binaryBeachLLC/tradewind/hardware/fab/drc_report.txt

** Drc report for tradewind.kicad_pcb **
** Created on 2026-10-11T23:57:10-1000 **

** Found 0 DRC violations **

** Found 0 unconnected pads **

** Found 0 Footprint errors **

** End of Report **
