binaryBeachLLC/tradewind/docs/figures/mech_mass_table.png

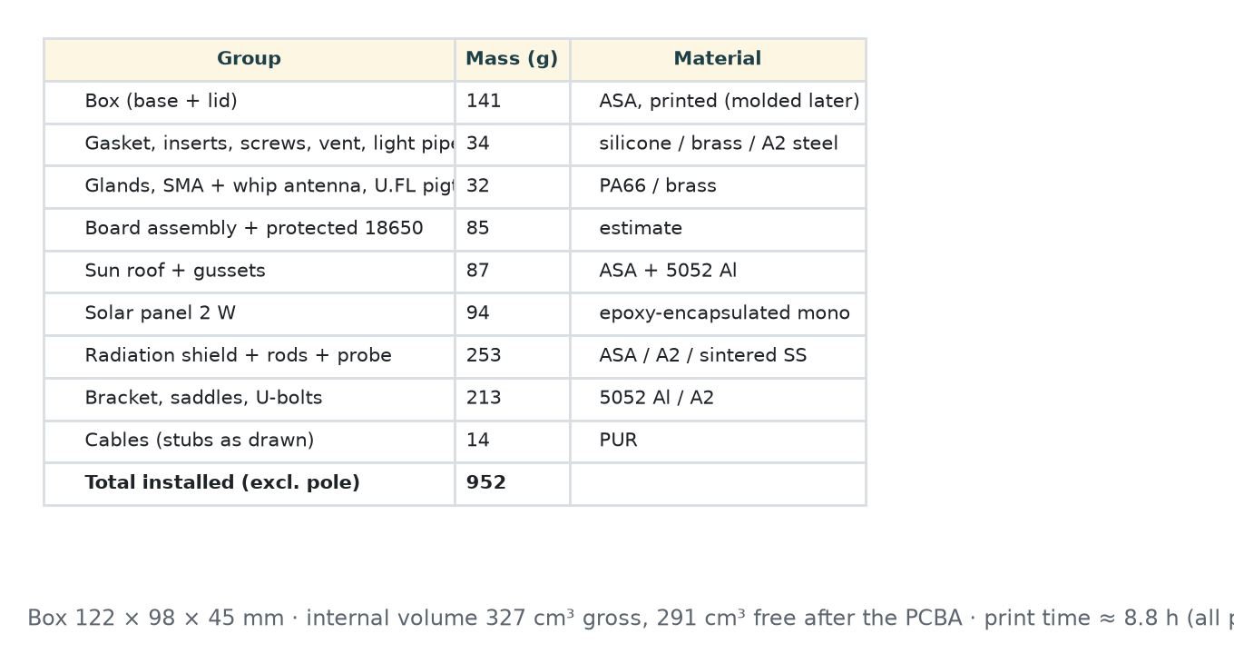
docs/figures/mech_mass_table.png
