binaryBeachLLC/tradewind/mechanical/out/previews/enclosure_front34.png

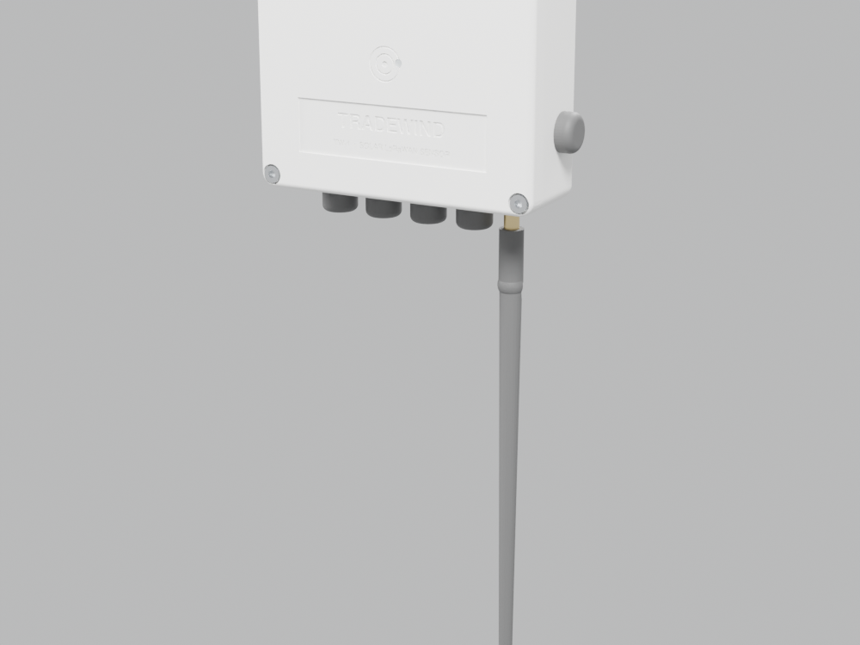
mechanical/out/previews/enclosure_front34.png
