binaryBeachLLC/tradewind/mechanical/out/previews/exploded_front34.png

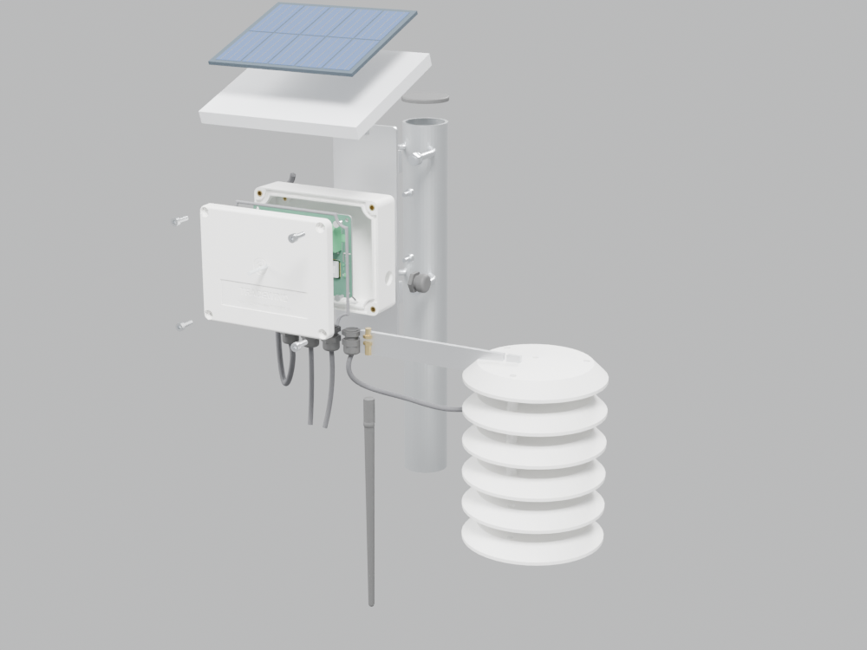
mechanical/out/previews/exploded_front34.png
