binaryBeachLLC/tradewind/render/out/jpg/kicad_pcb_bottom.jpg

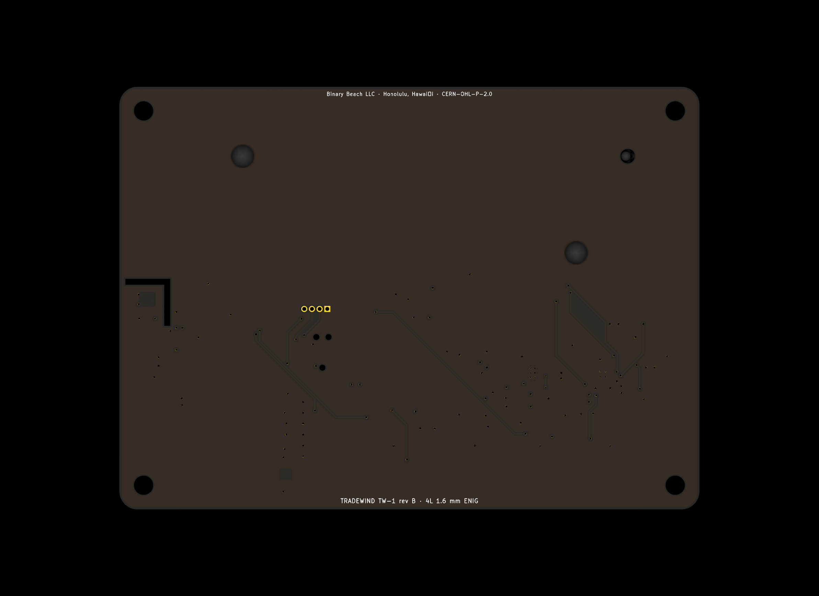
render/out/jpg/kicad_pcb_bottom.jpg
