binaryBeachLLC/tradewind/render/out/jpg/kicad_pcb_iso.jpg

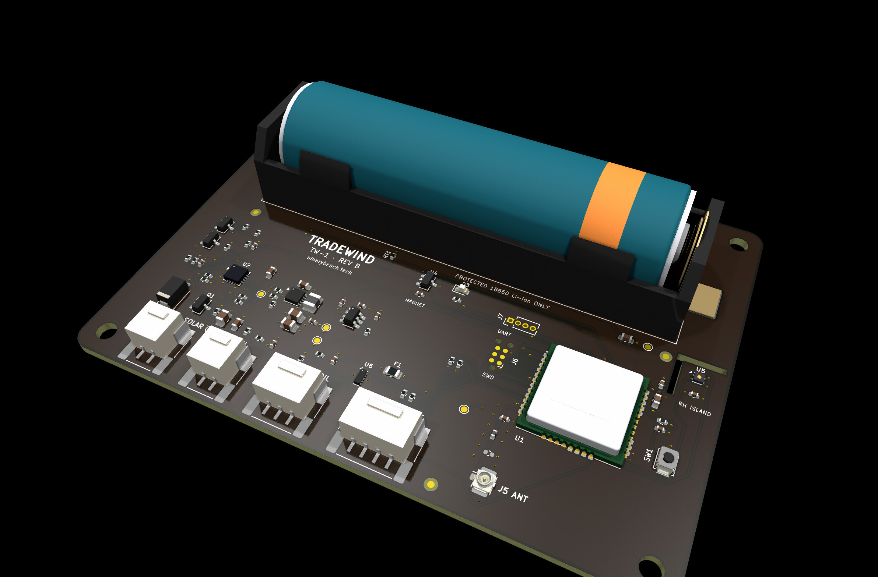
render/out/jpg/kicad_pcb_iso.jpg
