binaryBeachLLC/tradewind/render/out/jpg/pcb_top_ortho.jpg

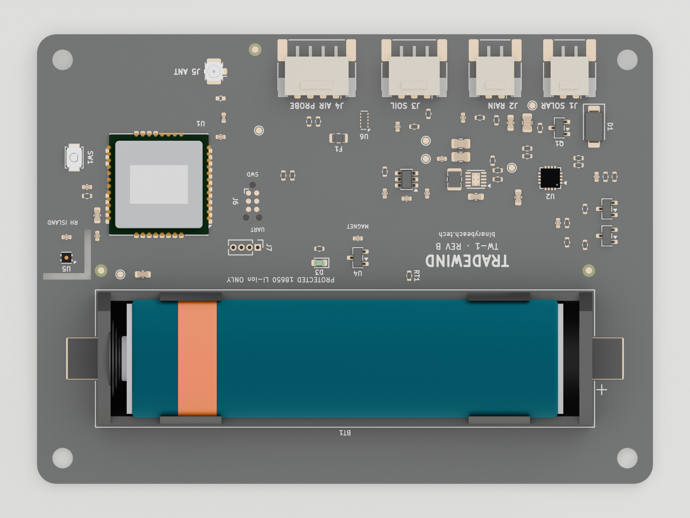
render/out/jpg/pcb_top_ortho.jpg
