binaryBeachLLC/tradewind/hardware/fab/BOM_JLCPCB.csv

Comment | Designator | Footprint | LCSC Part #
SOLAR S2B-PH-SM4-TB(LF)(SN) | J1 | JST_PH_S2B-PH-SM4-TB_1x02-1MP_P2.00mm_Horizontal
SMAJ12CA SMAJ12CA | D1 | D_SMA | C113951
DMP3099L DMP3099L-7 | Q1 | SOT-23 | C155407
100k RC0402FR-07100KL | R1,R11,R12,R15,R16 | R_0402_1005Metric
10µF GRM21BR61E106KA73L | C1 | C_0805_2012Metric
1µF GRM188R61E105KA12D | C2 | C_0603_1608Metric
BQ24074RGT BQ24074RGTR | U2 | VQFN-16-1EP_3x3mm_P0.5mm_EP1.6x1.6mm | C54313
1.78k RC0402FR-071K78L | R4 | R_0402_1005Metric
1.62k RC0402FR-071K62L | R5 | R_0402_1005Metric
4.7µF GRM188R61A475KE15D | C4,C5 | C_0603_1608Metric
18650 1042 | BT1 | BatteryHolder_Keystone_1042_1x18650
10k B3380 NCP15XH103F03RC | RT1 | R_0402_1005Metric
TPS63900 TPS63900DSKR | U3 | WSON-10-1EP_2.5x2.5mm_P0.5mm_EP1.2x2mm_ThermalVias | C2683460
10µF GRM188R61A106KE69D | C6,C12 | C_0603_1608Metric
2.2µH DFE252012F-2R2M=P2 | L1 | L_1008_2520Metric
36.5k RC0402FR-0736K5L | R6 | R_0402_1005Metric
0 RC0402JR-070RL | R7 | R_0402_1005Metric
16.2k RC0402FR-0716K2L | R8 | R_0402_1005Metric
22µF GRM21BR61A226ME51L | C7,C8 | C_0805_2012Metric
100nF GRM155R71C104KA88D | C3,C9,C11,C13,C16,C17,C21 | C_0402_1005Metric
AO3401A AO3401A | Q2 | SOT-23 | C15127
1M RC0402FR-071ML | R2,R9,R10,R21,R23 | R_0402_1005Metric
BSS138 BSS138LT1G | Q3 | SOT-23 | C78284
10nF GRM155R71C103KA01D | C10 | C_0402_1005Metric
330k RC0402FR-07330KL | R3 | R_0402_1005Metric
RAK3172-8-SM-I RAK3172-8-SM-I | U1 | RAK3172 | C2924540
10k RC0402FR-0710KL | R13,R24 | R_0402_1005Metric
RESET B3U-1000P | SW1 | SW_SPST_B3U-1000P
U.FL U.FL-R-SMT-1(10) | J5 | U.FL_Hirose_U.FL-R-SMT-1_Vertical | C88374
7.5nH LQG15HS7N5J02D | L2 | L_0402_1005Metric
1.8pF GJM1555C1H1R8BB01D | C14 | C_0402_1005Metric
GREEN LTST-C191KGKT | D3 | LED_0603_1608Metric
2.2k RC0402FR-072K2L | R14 | R_0402_1005Metric
DRV5032FB DRV5032FBDBZR | U4 | SOT-23 | C1850416
SHT40-BD1B SHT40-BD1B-R2 | U5 | Sensirion_DFN-4_1.5x1.5mm_P0.8mm_SHT4x_NoCentralPad | C2758077
4.7k RC0402FR-074K7L | R17,R18 | R_0402_1005Metric
AIR PROBE S4B-PH-SM4-TB(LF)(SN) | J4 | JST_PH_S4B-PH-SM4-TB_1x04-1MP_P2.00mm_Horizontal
100mA MF-PSMF010X-2 | F1 | Fuse_0805_2012Metric
100 RC0402FR-07100RL | R19,R20,R25 | R_0402_1005Metric
TPD4E02B04 TPD4E02B04DQAR | U6 | USON-10_2.5x1.0mm_P0.5mm | C1974361
TPS22917 TPS22917DBVR | U7 | SOT-23-6 | C2155396
1µF GRM155R61A105KE15D | C19,C20 | C_0402_1005Metric
1nF GRM155R71H102KA01D | C18 | C_0402_1005Metric
SOIL S3B-PH-SM4-TB(LF)(SN) | J3 | JST_PH_S3B-PH-SM4-TB_1x03-1MP_P2.00mm_Horizontal
1k RC0402FR-071KL | R22 | R_0402_1005Metric
RAIN S2B-PH-SM4-TB(LF)(SN) | J2 | JST_PH_S2B-PH-SM4-TB_1x02-1MP_P2.00mm_Horizontal
22nF GRM155R71C223KA01D | C22 | C_0402_1005Metric
