binaryBeachLLC/tradewind/mechanical/out/tradewind_assembly.step

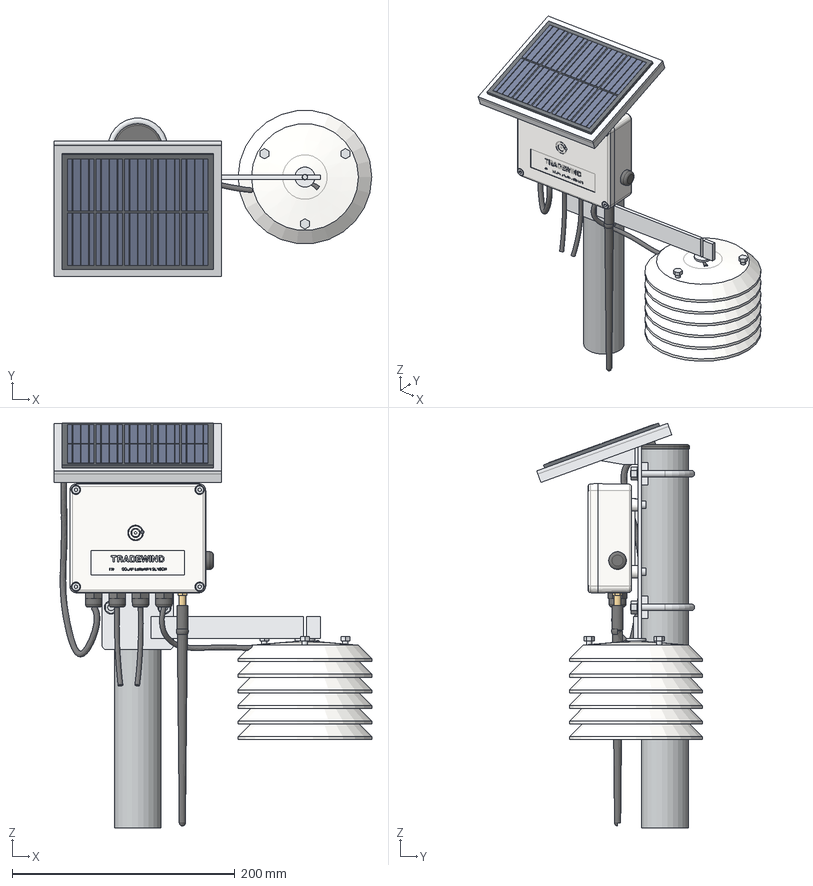
[picture p100: CAD file, 2026-10-12]
mechanical/out/tradewind_assembly.step
285.0 x 148.6 x 363.4 mm
base
lid
light_pipe
roof
panel
panel_cells
panel_busbars
panel_jbox
roof_gusset_L
roof_gusset_R
shield_cap
shield_plate_1
shield_plate_2
shield_plate_3
shield_plate_4
shield_plate_5
shield_rods
shield_spacers
probe_holder
probe_tip
probe_body
shield_arm
bracket_plate
ubolts
pole_saddles
pole_cap
pole
gasket
inserts
lid_screws
pcb_screws
bracket_screws
glands_pg7
sma_bulkhead
antenna_915
ufl_pigtail
vent_m12
cable_solar
cable_probe
cable_rain
cable_soil
pcba
