binaryBeachLLC/tradewind/hardware/fab/3d/tradewind_revB.step

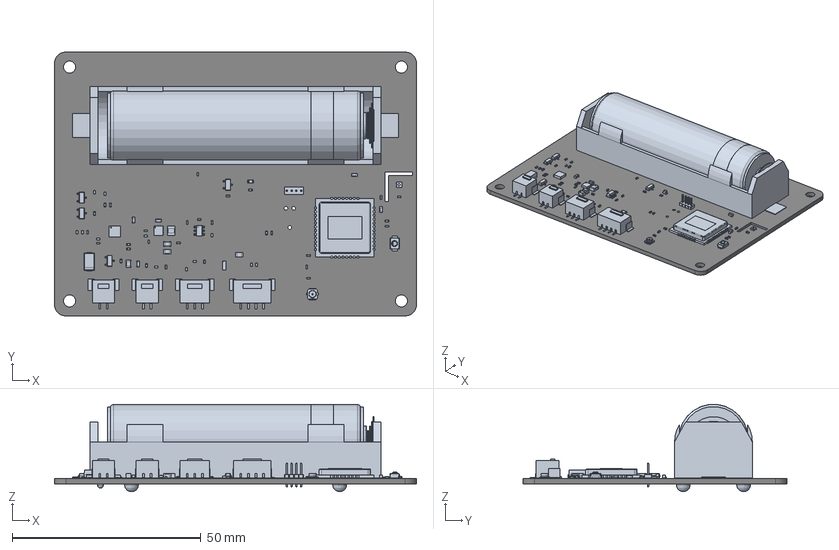
[picture p101: CAD file, 2026-10-12]
hardware/fab/3d/tradewind_revB.step
96.0 x 70.0 x 23.1 mm
R_0402_1005Metric x 26
housing x 4
metal x 4
C_0402_1005Metric x 14
Fuse_0805_2012Metric
pcb
pads x 3
shield
label
C_0603_1608Metric x 5
C_0805_2012Metric x 3
SOT-23 x 4
LED_0603_1608Metric
U.FL_Hirose_U.FL-R-SMT-1_Vertical
tradewind_revB 1.38.1
PinHeader_1x04_P1.27mm_Vertical
window
D_SMA
SOT-23-6
L_1008_2520Metric
USON-10_2.5x1.0mm_P0.5mm
SW_SPST_B3U-1000P
L_0402_1005Metric
pin1
BatteryHolder_Keystone_1042_1x18650
wrap
band
pos
neg
tradewind_PCB
