binaryBeachLLC/tradewind/hardware/tradewind/3d/JST_PH_S3B-PH-SM4-TB.step

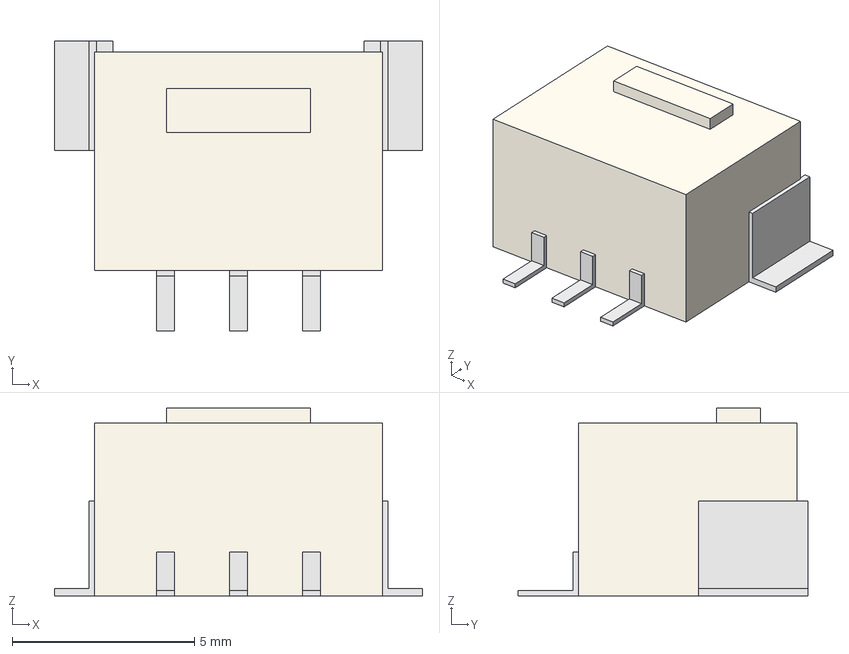
[picture p102: CAD file, 2026-10-12]
hardware/tradewind/3d/JST_PH_S3B-PH-SM4-TB.step
10.1 x 7.95 x 5.15 mm
housing
metal
