binaryBeachLLC/tradewind/mechanical/out/stl/base.stl

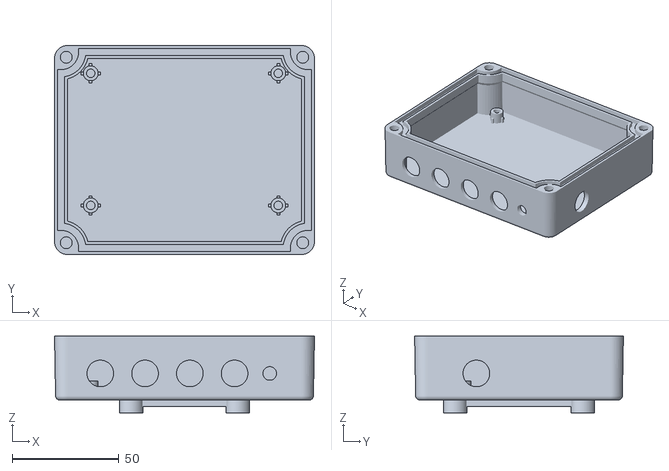
[picture p103: CAD file, 2026-10-12]
mechanical/out/stl/base.stl
122.0 x 98.0 x 36.0
