binaryBeachLLC/tradewind/hardware/tradewind/3d/Cell_18650_protected.step

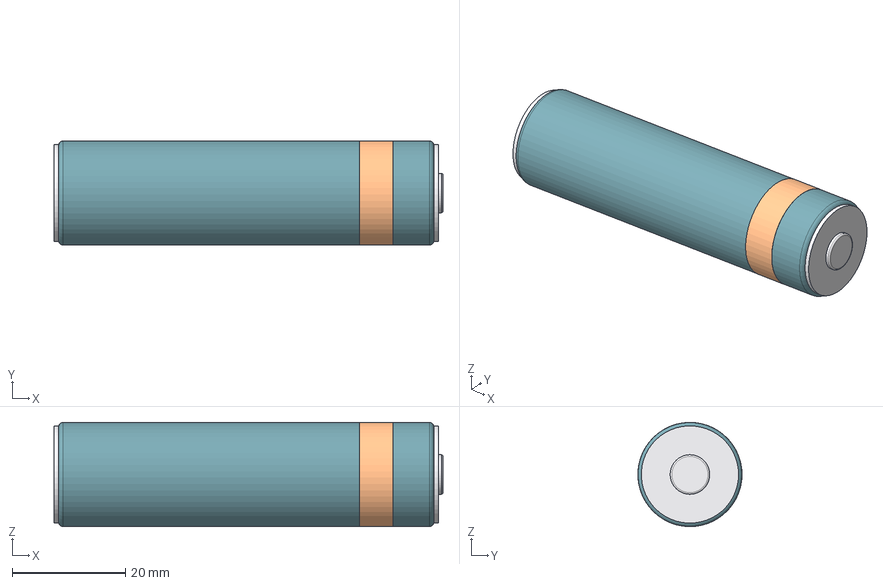
[picture p104: CAD file, 2026-10-12]
hardware/tradewind/3d/Cell_18650_protected.step
68.8 x 18.4 x 18.4 mm
wrap
band
pos
neg
