binaryBeachLLC/tradewind/mechanical/out/stl/roof.stl

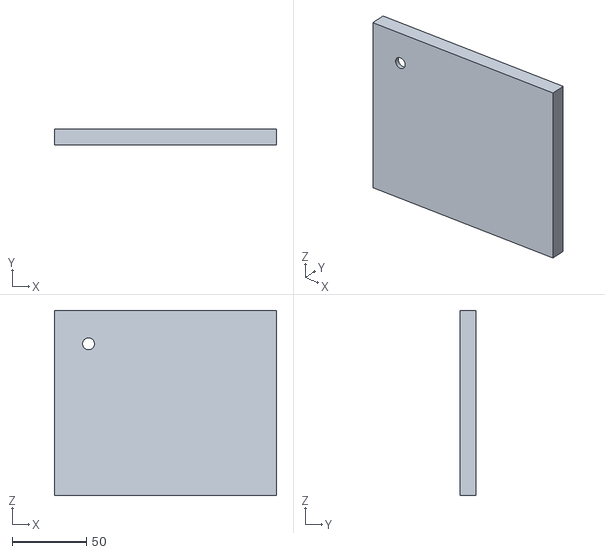
[picture p105: CAD file, 2026-10-12]
mechanical/out/stl/roof.stl
150.0 x 11.0 x 125.0
