binaryBeachLLC/tradewind/hardware/tradewind/3d/JST_PH_S2B-PH-SM4-TB.step

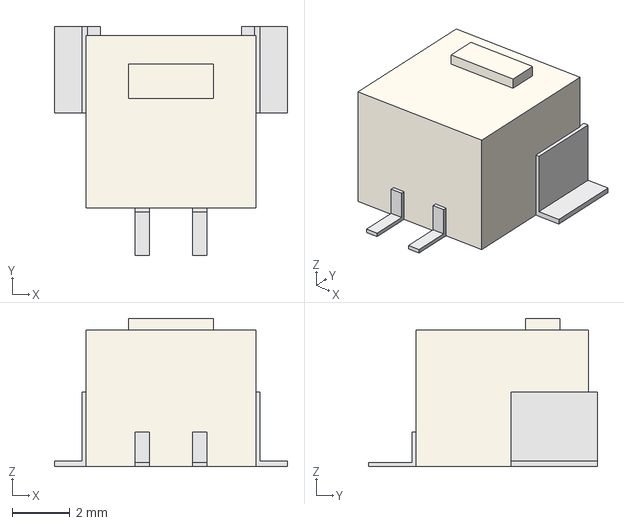
[picture p106: CAD file, 2026-10-12]
hardware/tradewind/3d/JST_PH_S2B-PH-SM4-TB.step
8.10 x 7.95 x 5.15 mm
housing
metal
