binaryBeachLLC/tradewind/mechanical/out/stl/shield_plate_x5.stl

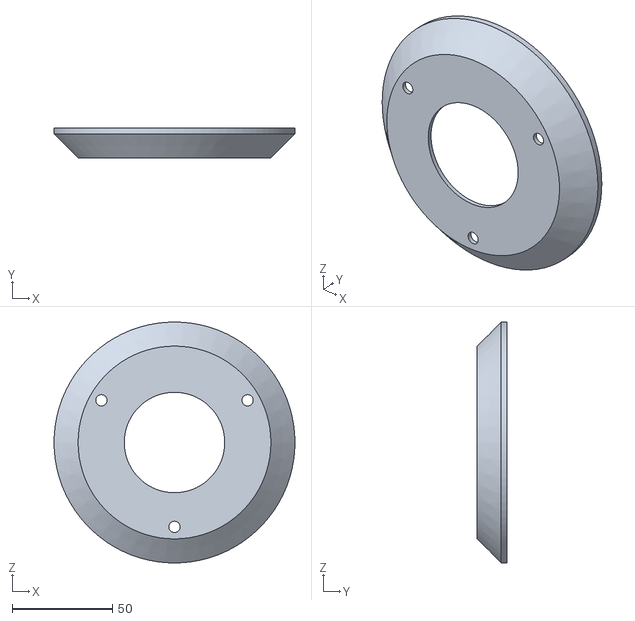
[picture p107: CAD file, 2026-10-12]
mechanical/out/stl/shield_plate_x5.stl
120.0 x 14.8 x 120.0
