binaryBeachLLC/tradewind/hardware/tradewind/3d/RAK3172.step

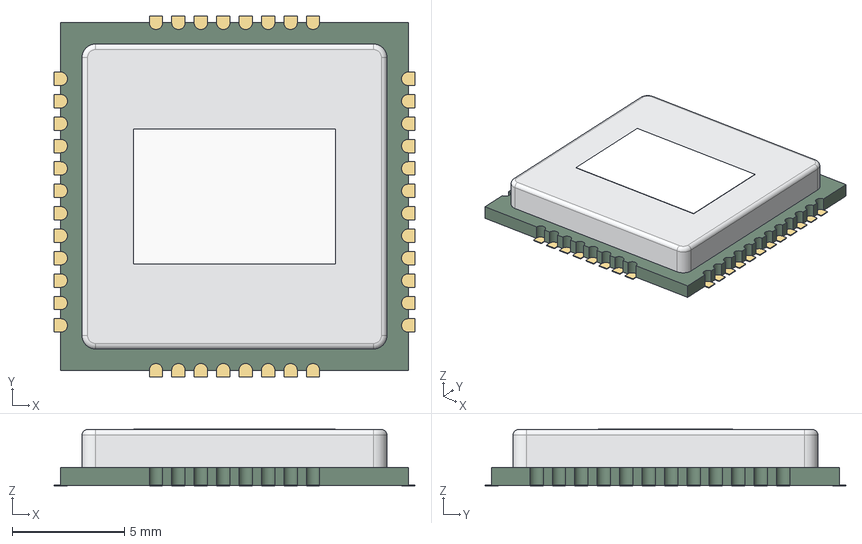
[picture p108: CAD file, 2026-10-12]
hardware/tradewind/3d/RAK3172.step
16.1 x 16.1 x 2.54 mm
pcb
pads
shield
label
