binaryBeachLLC/tradewind/mechanical/out/stl/probe_holder.stl

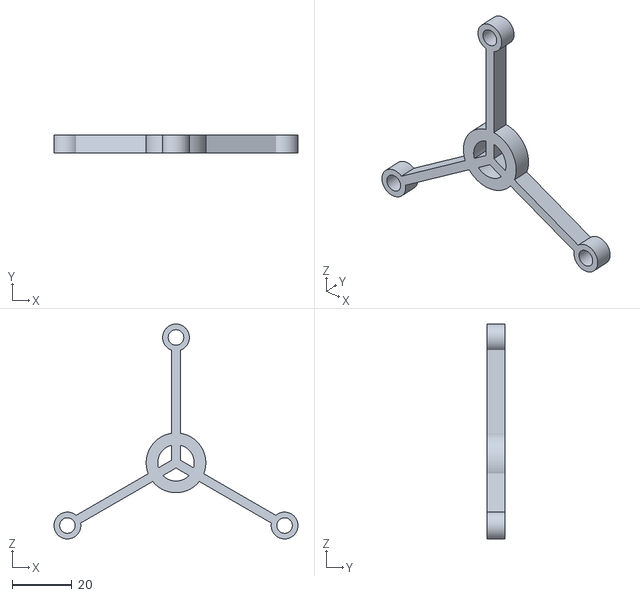
[picture p109: CAD file, 2026-10-12]
mechanical/out/stl/probe_holder.stl
81.7 x 6.00 x 72.0
