binaryBeachLLC/tradewind/mechanical/out/stl/shield_spacers_x15.stl

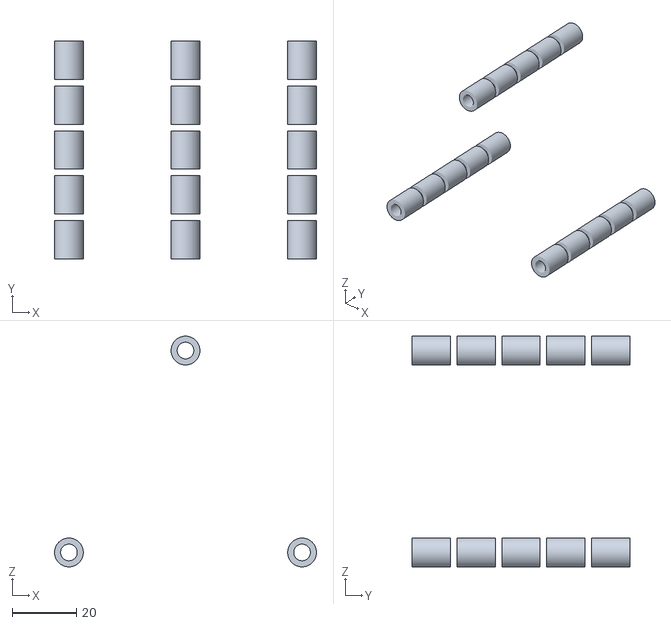
[picture p111: CAD file, 2026-10-12]
mechanical/out/stl/shield_spacers_x15.stl
81.7 x 68.0 x 72.0
