binaryBeachLLC/tradewind/hardware/tradewind/3d/Sensirion_DFN-4_1.5x1.5mm_SHT4x.step

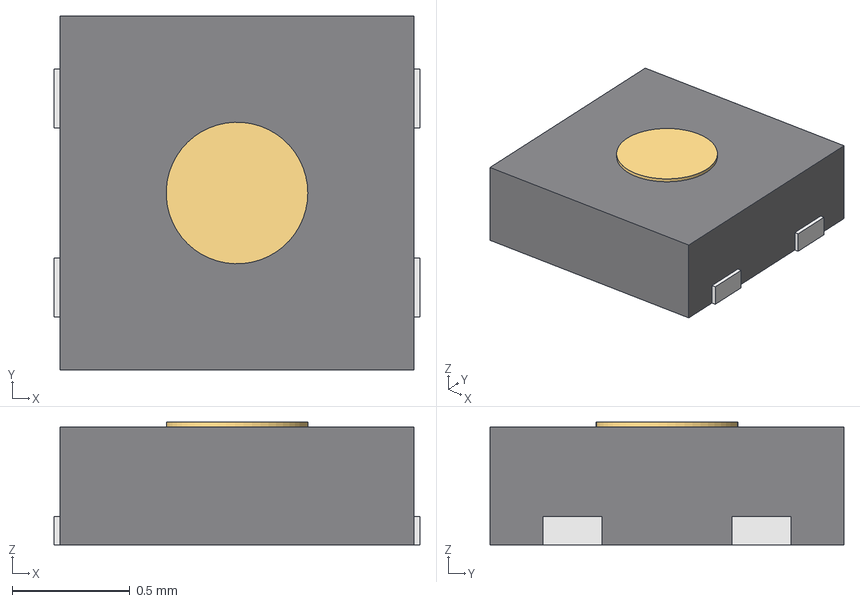
[picture p112: CAD file, 2026-10-12]
hardware/tradewind/3d/Sensirion_DFN-4_1.5x1.5mm_SHT4x.step
1.55 x 1.50 x 0.52 mm
window
pads
