binaryBeachLLC/tradewind/mechanical/out/stl/lid.stl

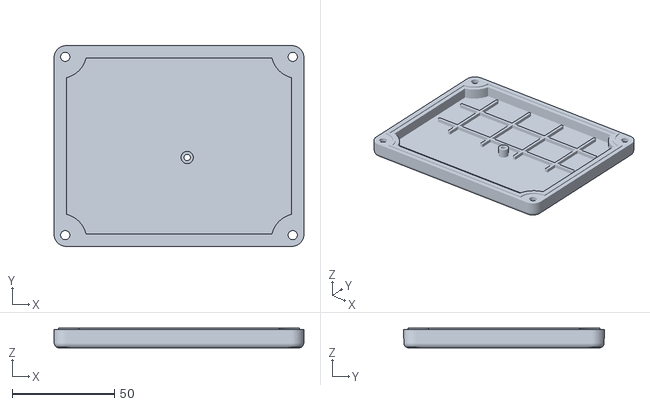
[picture p113: CAD file, 2026-10-12]
mechanical/out/stl/lid.stl
122.0 x 98.0 x 9.75
