binaryBeachLLC/tradewind/hardware/tradewind/3d/VQFN-16_3x3mm_P0.5mm.step

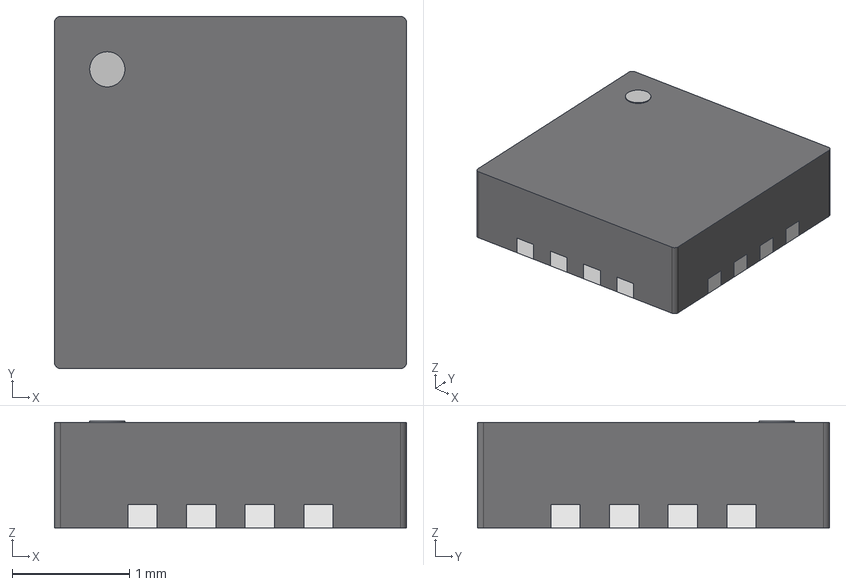
[picture p114: CAD file, 2026-10-12]
hardware/tradewind/3d/VQFN-16_3x3mm_P0.5mm.step
3.00 x 3.00 x 0.91 mm
pads
pin1
