binaryBeachLLC/tradewind/mechanical/out/stl/shield_cap.stl

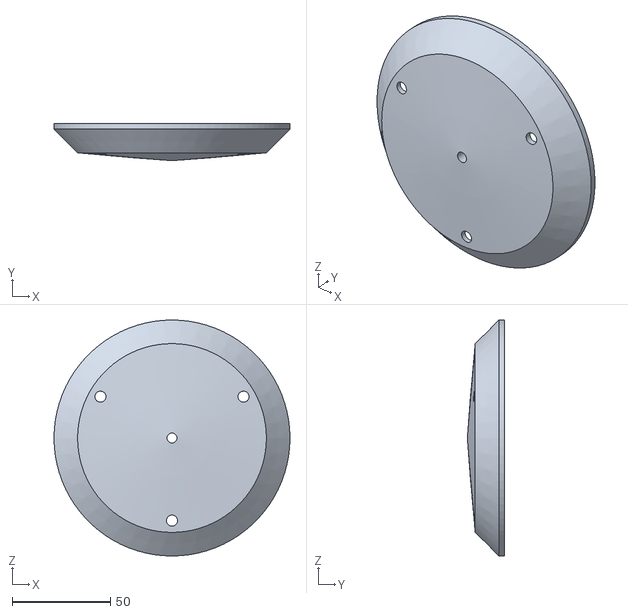
[picture p115: CAD file, 2026-10-12]
mechanical/out/stl/shield_cap.stl
120.0 x 18.6 x 120.0
