binaryBeachLLC/tradewind/docs/figures/mech_ga_installed.png

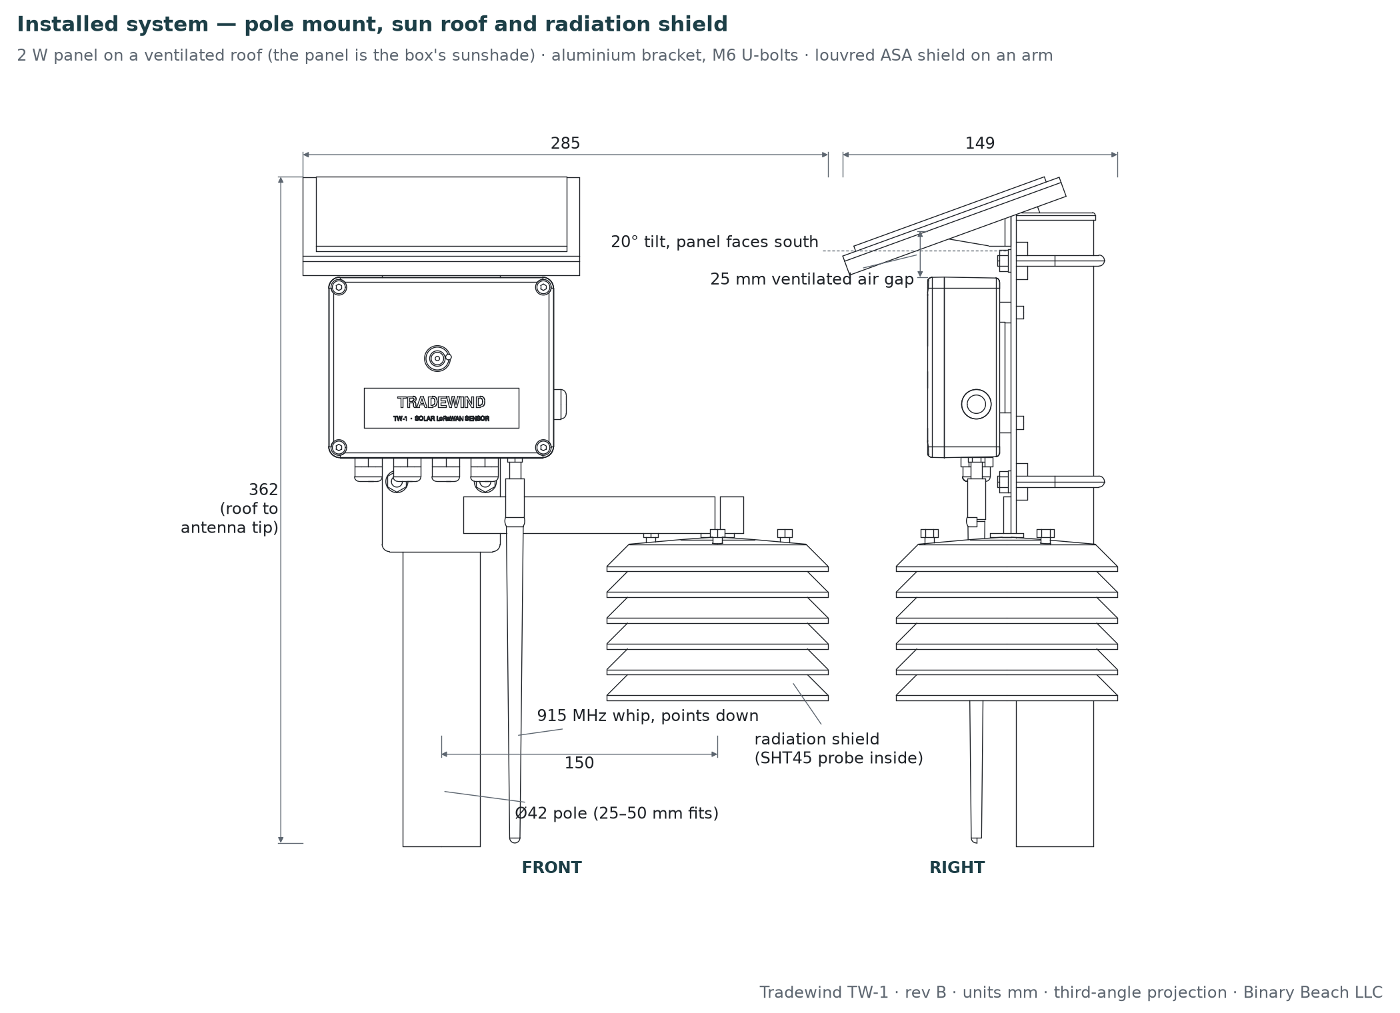
docs/figures/mech_ga_installed.png
