binaryBeachLLC/tradewind/mechanical/out/previews/assembly_rear34.png

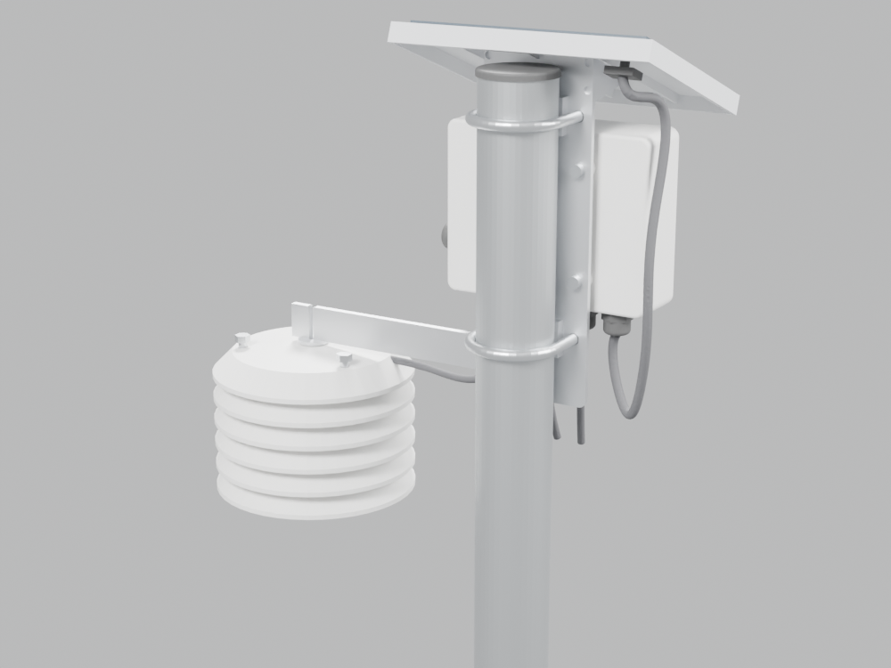
mechanical/out/previews/assembly_rear34.png
