binaryBeachLLC/tradewind/test/data/bringup_revB_rails.csv

# Rev B bring-up | 10 boards. Rails with DMM (4.5 digit). Ripple: scope 20 MHz BW limit | 10 mA load.
# Sleep current: PPK2 source mode | 60 s average after 30 s settle | firmware in STOP2 | probes/panel unplugged.
serial | v3v3_V | v3v3_ripple_mVpp_10mA | vsys_V_sun | vbat_reg_V | sleep_uA_3V7 | sleep_uA_4V2 | flash_s | otaa_join_s | tx_dBm_915
TW1B-001 | 3.311 | 18.7 | 4.394 | 4.194 | 6.8 | 7.23 | 11.5 | 5.6 | 19.7
TW1B-002 | 3.306 | 19.0 | 4.414 | 4.202 | 7.1 | 7.4 | 12.2 | 6.9 | 19.6
TW1B-003 | 3.298 | 17.3 | 4.421 | 4.213 | 7.4 | 7.81 | 11.4 | 5.9 | 20.3
TW1B-004 | 3.315 | 16.5 | 4.395 | 4.202 | 6.9 | 7.2 | 11.3 | 6.7 | 20.3
TW1B-005 | 3.29 | 14.7 | 4.43 | 4.198 | 7.6 | 8.02 | 12.0 | 5.5 | 20.0
TW1B-006 | 3.312 | 17.3 | 4.407 | 4.205 | 7.2 | 7.65 | 10.9 | 5.8 | 19.9
TW1B-007 | 3.293 | 19.6 | 4.404 | 4.202 | 8.1 | 8.68 | 11.1 | 5.5 | 19.7
TW1B-008 | 3.294 | 16.2 | 4.438 | 4.2 | 7.0 | 7.38 | 12.0 | 6.0 | 19.7
TW1B-009 | 3.301 | 20.7 | 4.396 | 4.209 | 7.3 | 7.71 | 11.6 | 6.9 | 19.8
TW1B-010 | 3.305 | 18.0 | 4.427 | 4.202 | 6.7 | 7.11 | 13.3 | 6.6 | 19.7
