binaryBeachLLC/tradewind/test/data/buckboost_efficiency.csv

# U3 TPS63900 isolated (R removed to VSYS/OUT) | Jesverty supply into VIN | PPK2 on input below 1 mA
# DMM above 1 mA; electronic load (resistor decade below 1 mA). VOUT measured at C7 with 4-wire probe.
vin_V | iout_A | iin_A | efficiency_pct
3.0 | 1.000e-05 | 1.2639e-05 | 87.0
3.0 | 1.773e-05 | 2.1995e-05 | 88.7
3.0 | 3.144e-05 | 3.9050e-05 | 88.6
3.0 | 5.574e-05 | 6.7935e-05 | 90.3
3.0 | 9.884e-05 | 1.2019e-04 | 90.5
3.0 | 1.752e-04 | 2.1321e-04 | 90.4
3.0 | 3.107e-04 | 3.7394e-04 | 91.4
3.0 | 5.509e-04 | 6.6363e-04 | 91.3
3.0 | 9.769e-04 | 1.1662e-03 | 92.1
3.0 | 1.732e-03 | 2.0876e-03 | 91.3
3.0 | 3.071e-03 | 3.6698e-03 | 92.1
3.0 | 5.445e-03 | 6.5138e-03 | 92.0
3.0 | 9.655e-03 | 1.1526e-02 | 92.1
3.0 | 1.712e-02 | 2.0526e-02 | 91.7
3.0 | 3.035e-02 | 3.6521e-02 | 91.4
3.0 | 5.382e-02 | 6.4646e-02 | 91.6
3.0 | 9.543e-02 | 1.1581e-01 | 90.6
3.0 | 1.692e-01 | 2.0687e-01 | 90.0
3.0 | 3.000e-01 | 3.7326e-01 | 88.4
3.7 | 1.000e-05 | 1.0111e-05 | 88.2
3.7 | 1.773e-05 | 1.7726e-05 | 89.2
3.7 | 3.144e-05 | 3.1184e-05 | 89.9
3.7 | 5.574e-05 | 5.4875e-05 | 90.6
3.7 | 9.884e-05 | 9.5857e-05 | 92.0
3.7 | 1.752e-04 | 1.7009e-04 | 91.9
3.7 | 3.107e-04 | 2.9984e-04 | 92.4
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
