binaryBeachLLC/tradewind/test/data/dark_test_1min.csv

# Unit TW1B-010 | panel unplugged | 1-min rapid mode forced by downlink | SF9. INA219 coulomb count on the BAT lead
# rest voltage read at 03:00 each night. Room 24-28 C.
day | vbat_V_rest | soc_pct_coulomb
0 | 4.194 | 99.9
1 | 4.195 | 99.4
2 | 4.184 | 99.1
3 | 4.182 | 99.0
4 | 4.178 | 98.7
5 | 4.171 | 98.1
6 | 4.165 | 98.1
7 | 4.165 | 97.3
8 | 4.158 | 97.2
9 | 4.155 | 96.9
10 | 4.152 | 96.6
11 | 4.141 | 96.1
12 | 4.142 | 95.8
13 | 4.13 | 95.8
14 | 4.131 | 95.6
