binaryBeachLLC/tradewind/test/data/emi_radiated_prescan.csv

# Radiated emissions pre-scan | 3 m | rented semi-anechoic chamber (not an accredited test). Biconical 30-200 MHz
# log-periodic 200-1000 MHz | 1-4 m height scan | turntable 0-360 | peak detector | RBW 120 kHz. Antenna factors and
# cable loss applied. EUT: TW1B-004 in the closed enclosure on the pole bracket | 1 m probe and soil cables | panel
# on the roof in sun-lamp light (charger active) | radio idle between uplinks (rapid mode). Limit: FCC 15.109 class B.
freq_MHz | peak_dBuV_m_H | peak_dBuV_m_V
30.0 | 29.6 | 31.2
30.075 | 28.2 | 29.4
30.151 | 27.7 | 27.9
30.226 | 25.4 | 27.7
30.302 | 26.0 | 29.1
30.378 | 26.2 | 30.3
30.455 | 26.4 | 29.6
30.531 | 25.6 | 29.6
30.608 | 25.9 | 29.1
30.684 | 28.9 | 29.8
30.761 | 28.3 | 30.1
30.839 | 27.6 | 30.4
30.916 | 25.7 | 31.0
30.994 | 26.8 | 30.2
31.071 | 29.9 | 29.7
31.149 | 26.0 | 30.0
31.228 | 25.1 | 28.8
31.306 | 28.0 | 30.4
31.384 | 27.5 | 27.5
31.463 | 24.8 | 28.8
31.542 | 29.1 | 30.5
31.621 | 29.0 | 26.7
31.701 | 28.5 | 29.8
31.78 | 27.2 | 30.0
31.86 | 30.9 | 29.2
31.94 | 27.6 | 27.2
32.02 | 27.5 | 28.1
32.101 | 26.7 | 32.0
32.181 | 30.2 | 29.3
32.262 | 28.9 | 30.8
32.343 | 26.1 | 28.5
32.424 | 28.7 | 27.4
32.505 | 27.5 | 28.6
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
