binaryBeachLLC/tradewind/docs/figures/test_uv.png

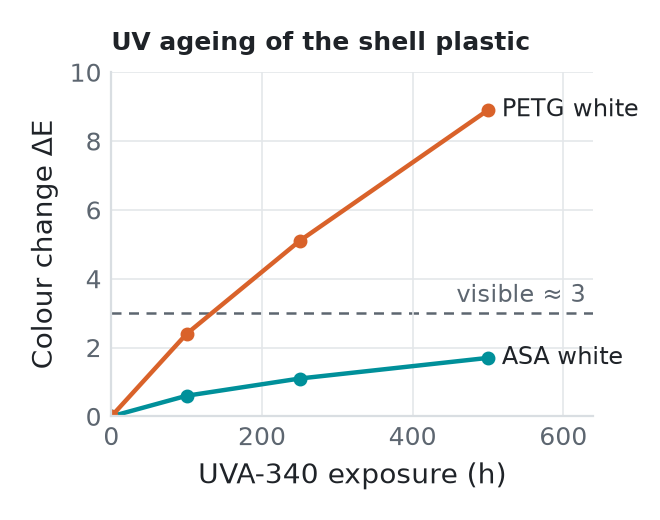
docs/figures/test_uv.png
