binaryBeachLLC/tradewind/docs/schematic/tradewind_schematic.pdf

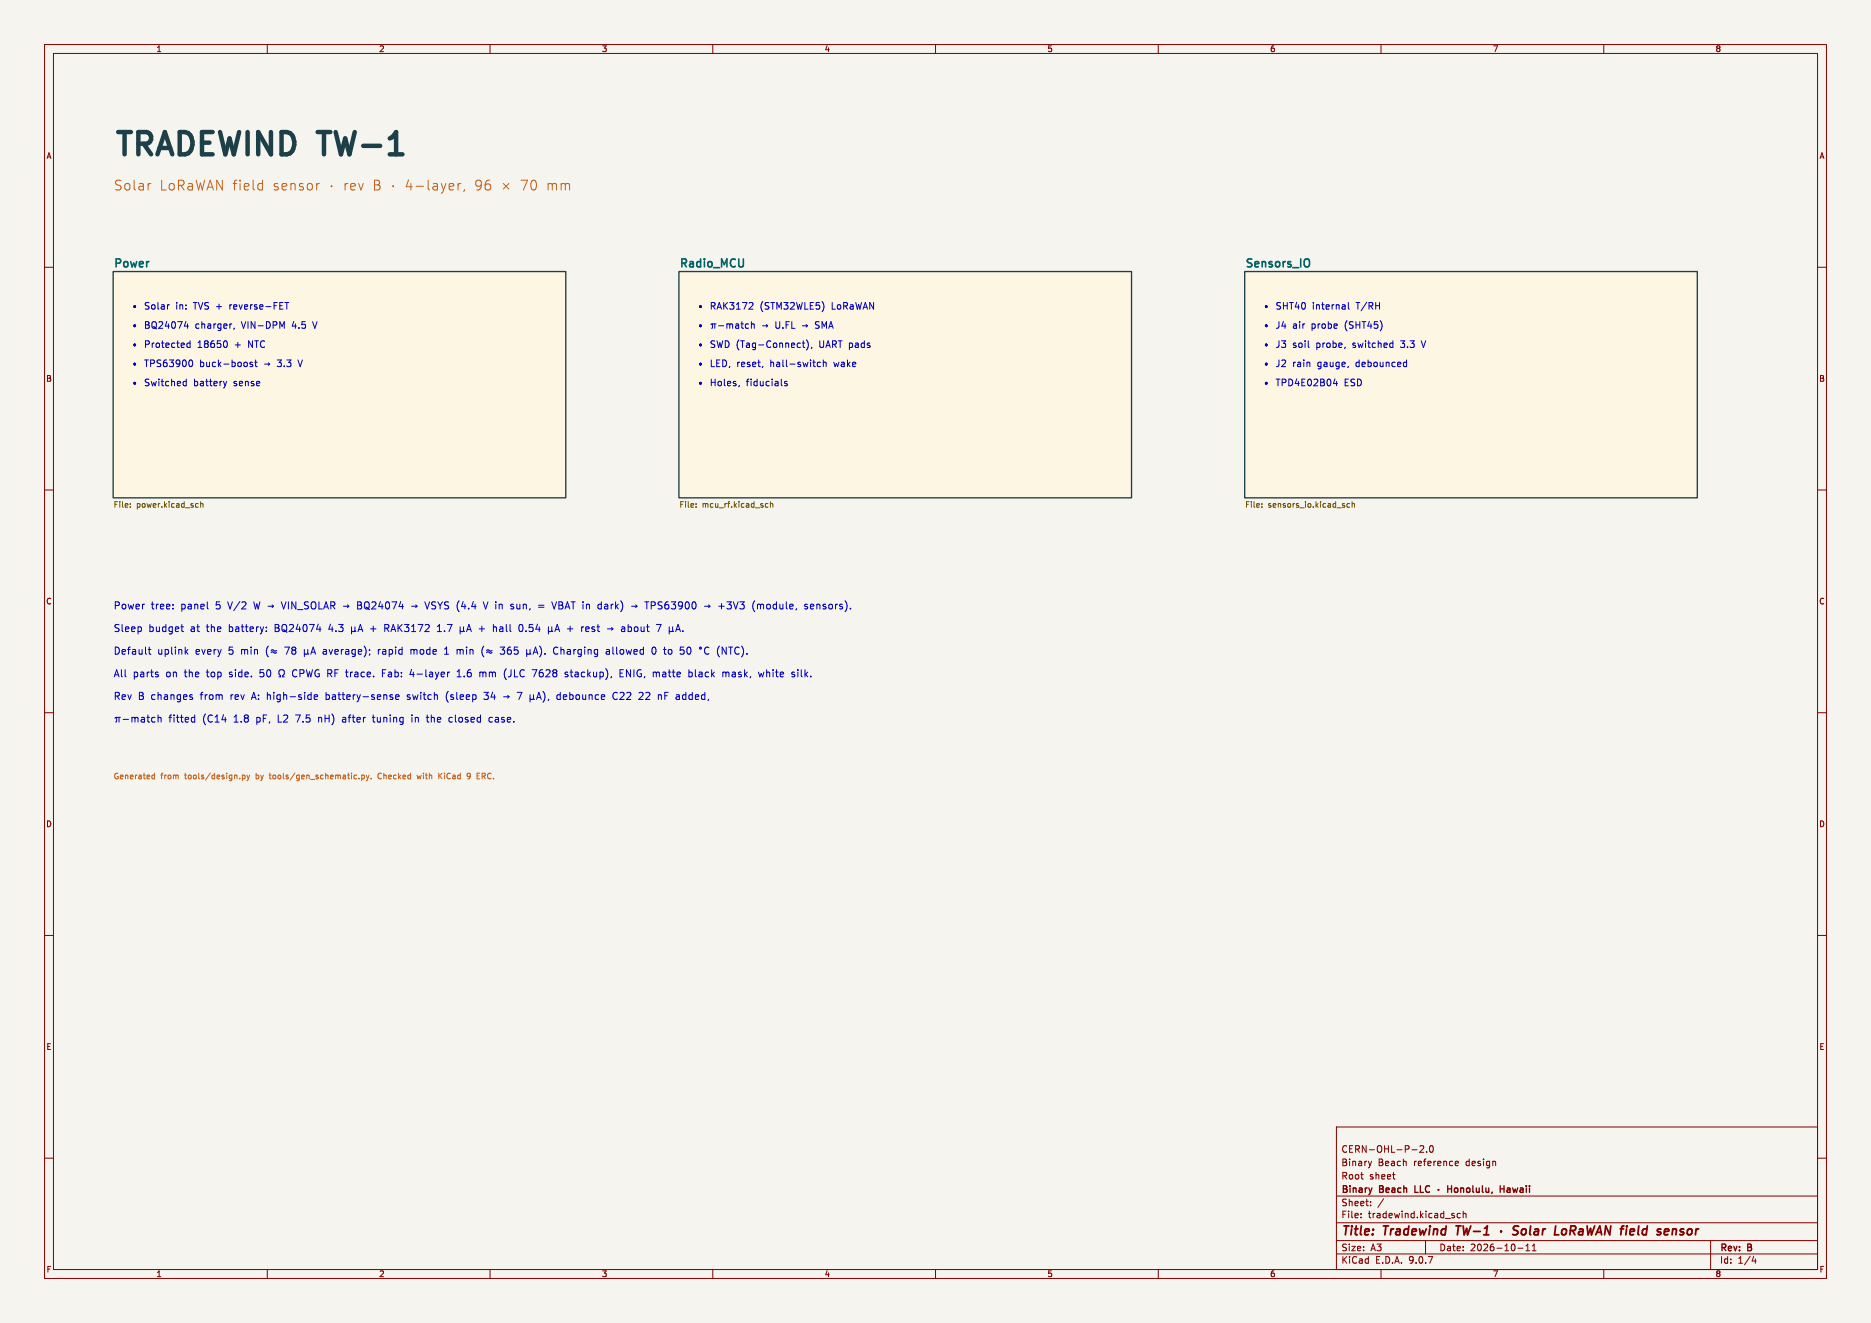
[picture p119: page 1]

þÿ "þÿÀ-matchþÿ!’U.FL þÿ!’SMA

þÿ "J4 air probe (SHT45)
þÿ "J3 soil probe, switched 3.3 V
þÿ "J2 rain gauge, debounced

þÿ "BQ24074 charger, VIN-DPM 4.5 V
þÿ "Switched battery sense

Default uplink every 5 min þÿ("H78 þÿµAaverage); rapid mode 1 min þÿ("H365 þÿµA). Charging allowed 0 to 50 þÿ°C(NTC).

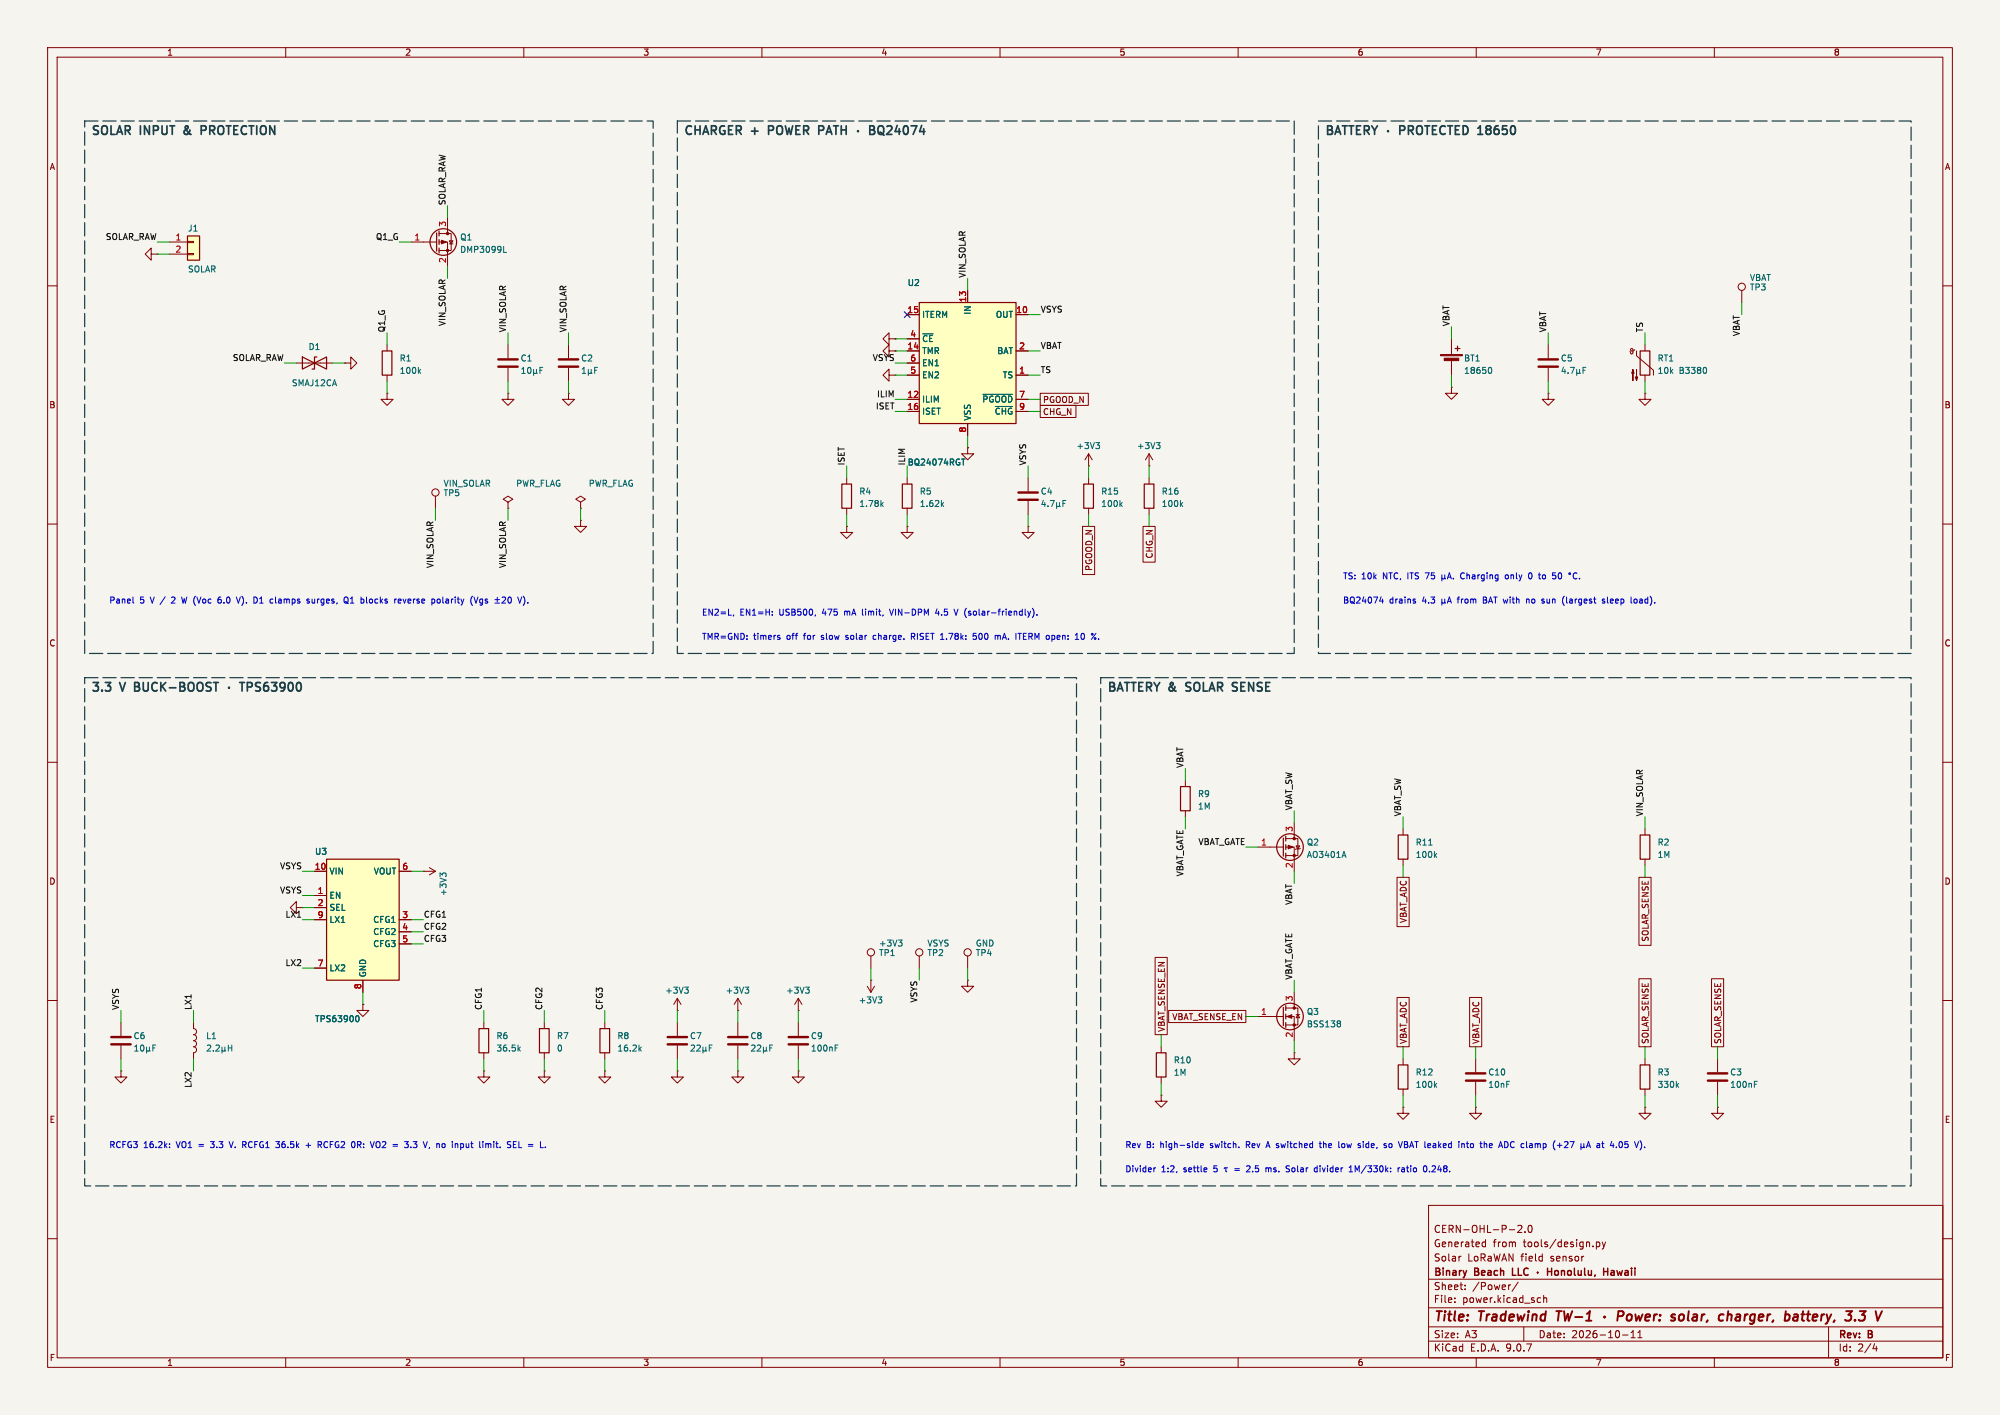
[picture p120: page 2]

CHARGER + POWER PATH þÿ·BQ24074

8 OUT 10 BAT 2 TS 1 ~{PGOOD}7 ~{CHG}9 U2BQ24074RGT CHG_N PGOOD_N
ITERM 15 ~{CE} 4 TMR 14 EN1 6 EN2 5

8 OUT 10 BAT 2 TS 1 ~{PGOOD}7 ~{CHG}9 U3 TPS63900 VIN 10 EN 1 SEL 2

TMR=GND: timers off for slow solar charge. RISET 1.78k: 500 mA. ITERM open: 10 %. EN2=L, EN1=H: USB500, 475 mA limit, VIN-DPM 4.5 V (solar-friendly). RCFG3 16.2k: VO1 = 3.3 V. RCFG1 36.5k + RCFG2 0R: VO2 = 3.3 V, no input limit. SEL = L.

Id: 2/4 Title: Tradewind TW-1 þÿ·Power: solar, charger, battery, 3.3 V

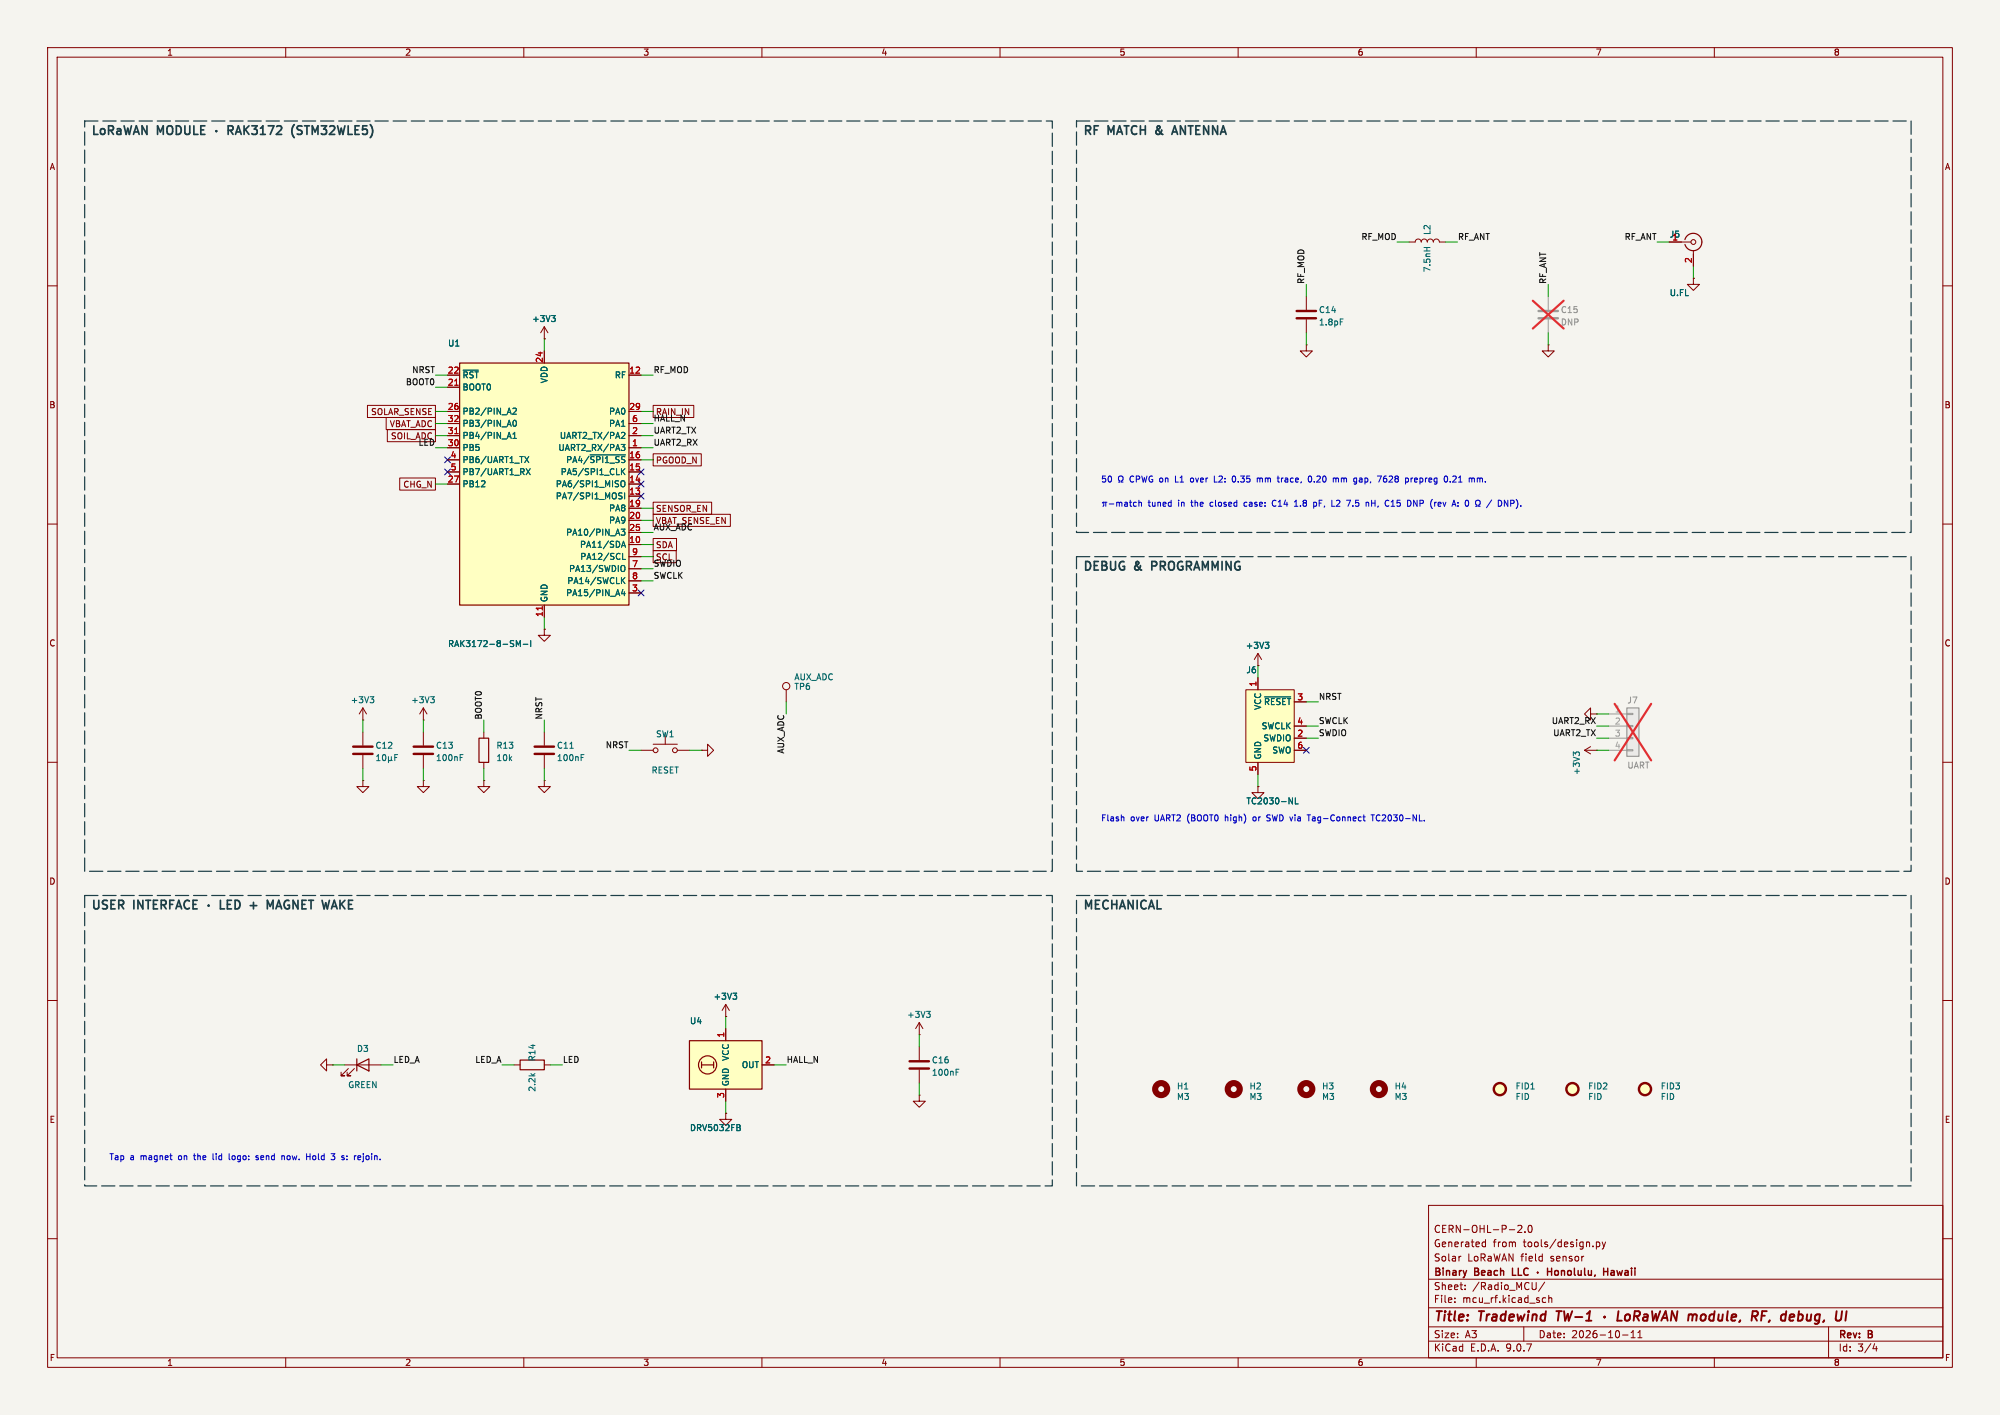
[picture p121: page 3]

50 þÿ©CPWG on L1 over L2: 0.35 mm trace, 0.20 mm gap, 7628 prepreg 0.21 mm. þÿÀ-matchtuned in the closed case: C14 1.8 pF, L2 7.5 nH, C15 DNP (rev A: 0 þÿ©/ DNP).

5 ~{RESET}3 SWCLK 4 SWDIO 2 SWO 6

Tap a magnet on the lid logo: send now. Hold 3 s: rejoin.

Id: 3/4 Title: Tradewind TW-1 þÿ·LoRaWAN module, RF, debug, UI File: mcu_rf.kicad_sch Sheet: /Radio_MCU/

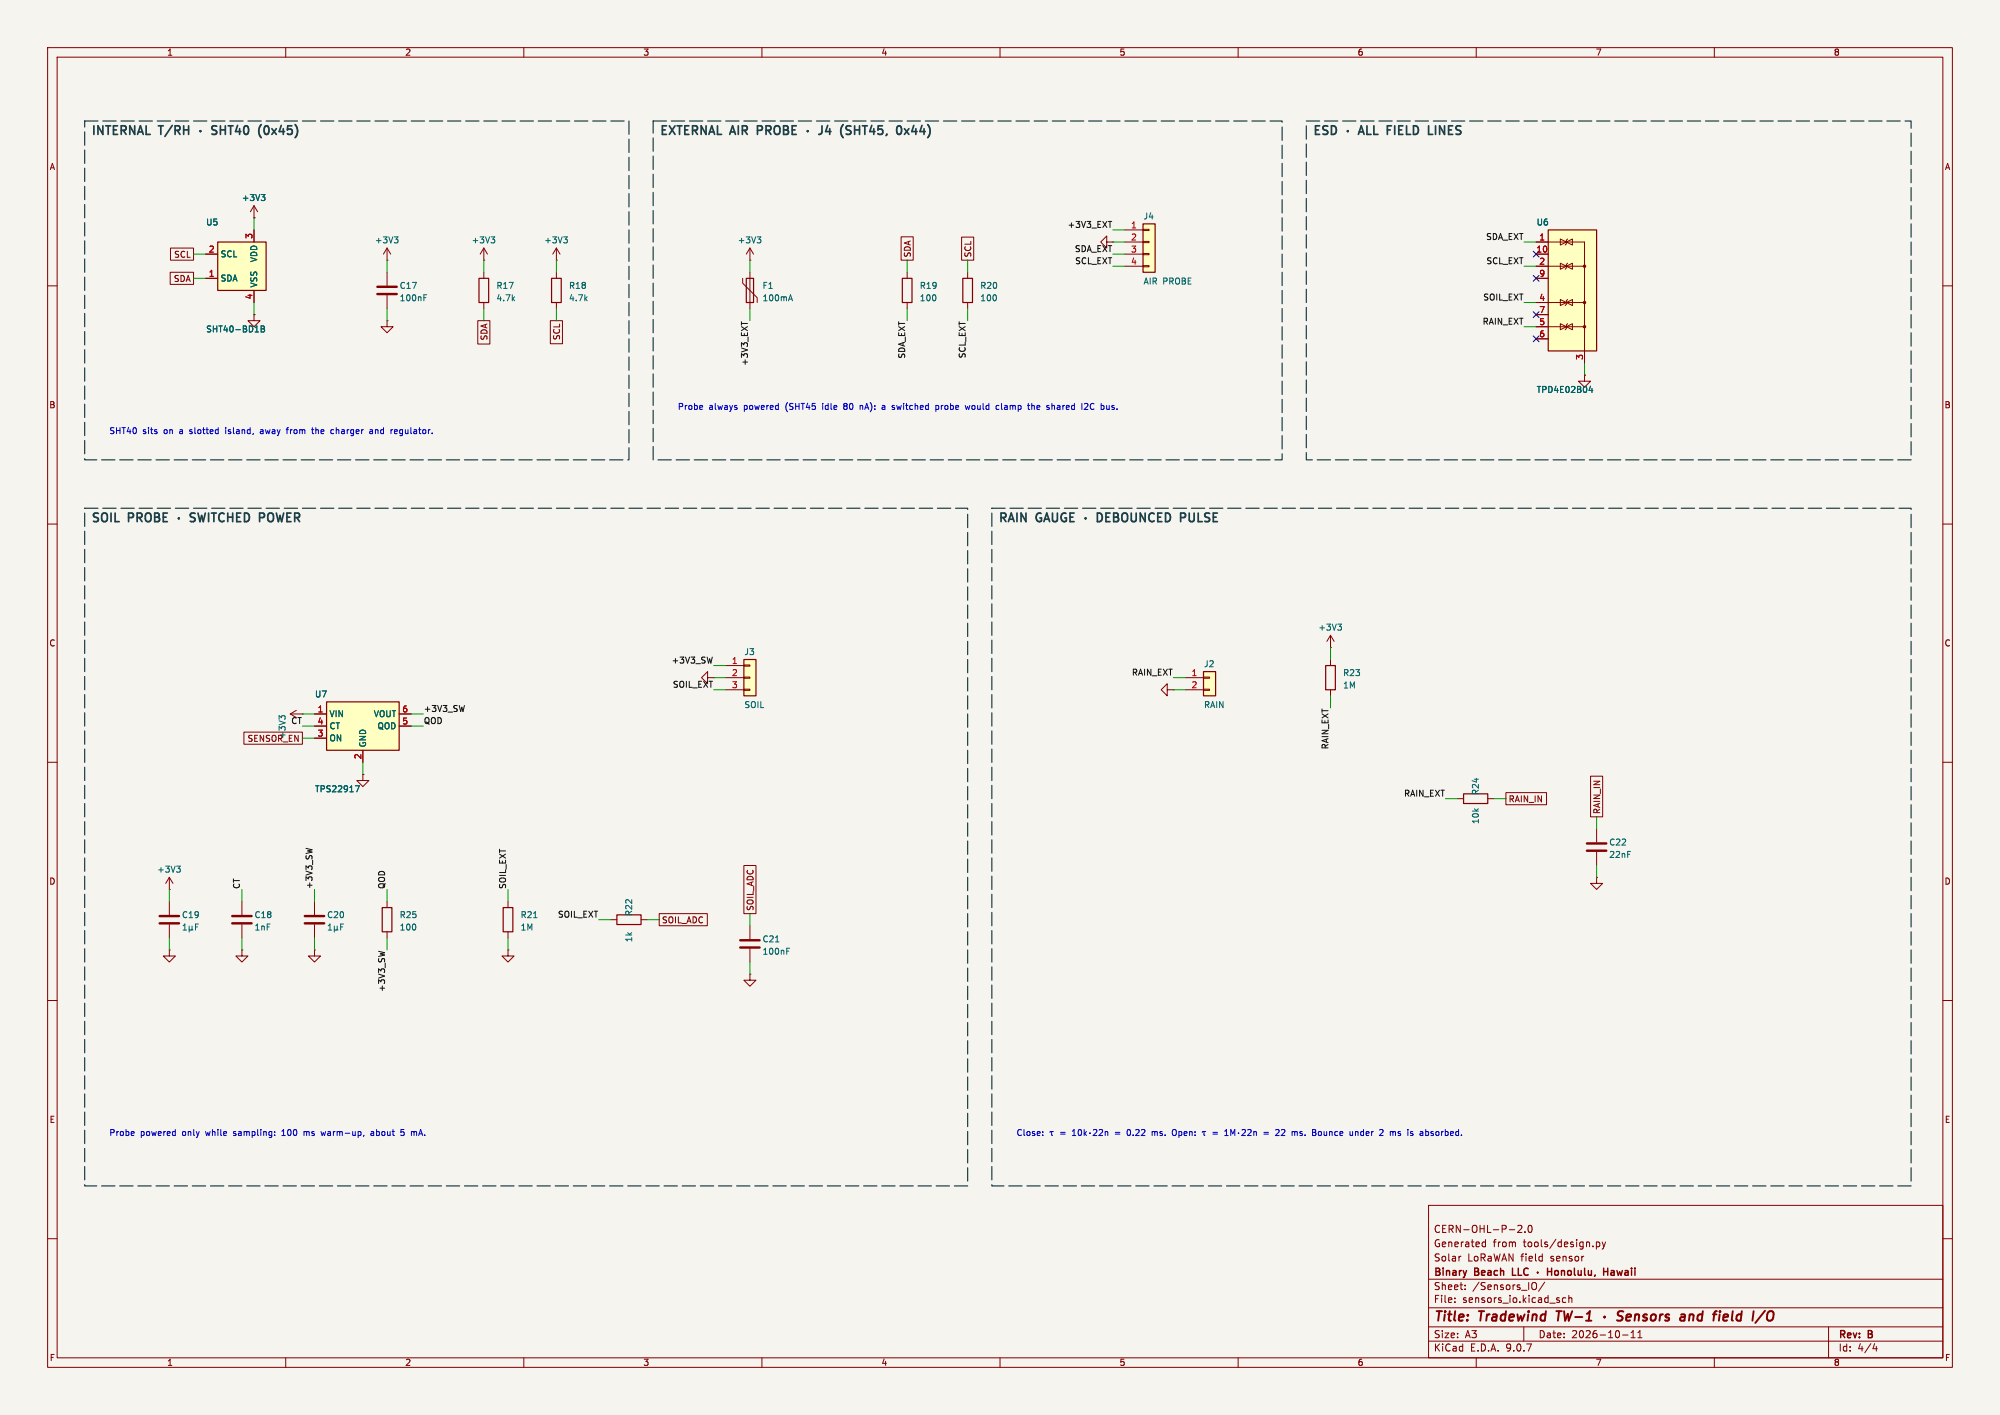
[picture p122: page 4]

SOIL PROBE þÿ·SWITCHED POWER

RAIN GAUGE þÿ·DEBOUNCED PULSE

Close: þÿÄ= þÿ10k·22n = 0.22 ms. Open: þÿÄ= þÿ1M·22n = 22 ms. Bounce under 2 ms is absorbed.

File: sensors_io.kicad_sch Sheet: /Sensors_IO/
Id: 4/4 Title: Tradewind TW-1 þÿ·Sensors and field I/O
