binaryBeachLLC/tradewind/hardware/fab/assembly/assembly_drawing_top.pdf

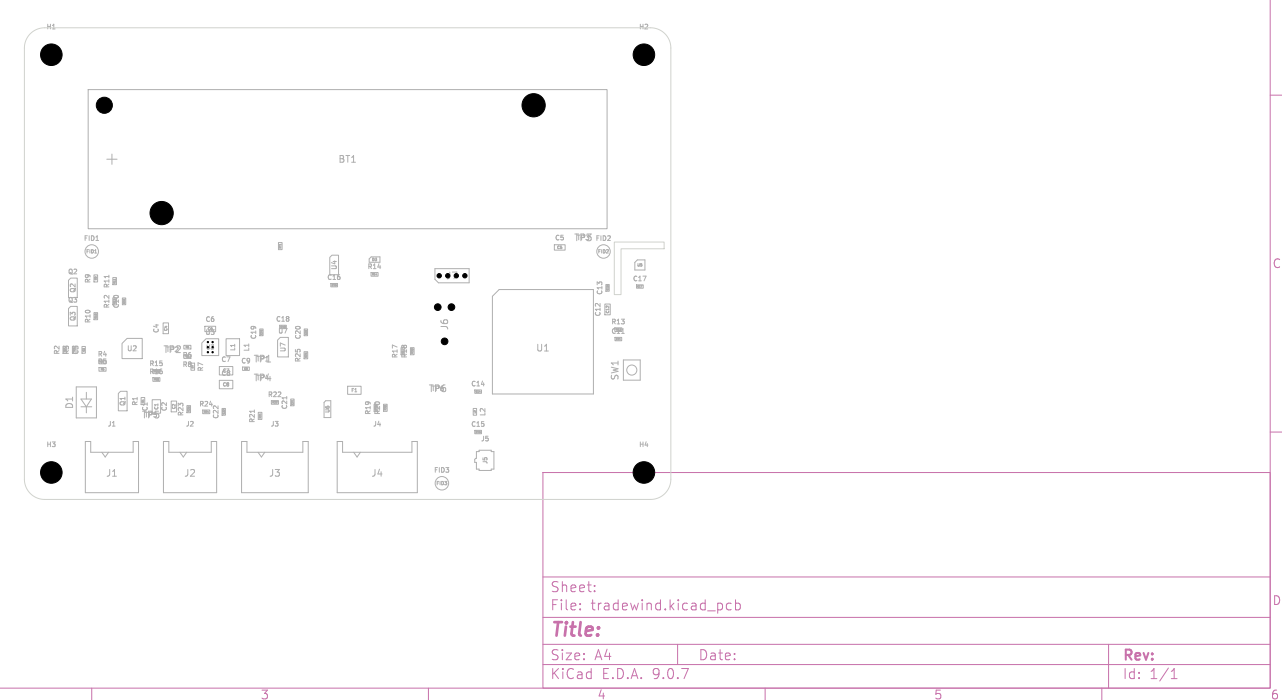
[picture p123: page 1]
