binaryBeachLLC/tradewind/hardware/fab/assembly/top_copper_silk.pdf

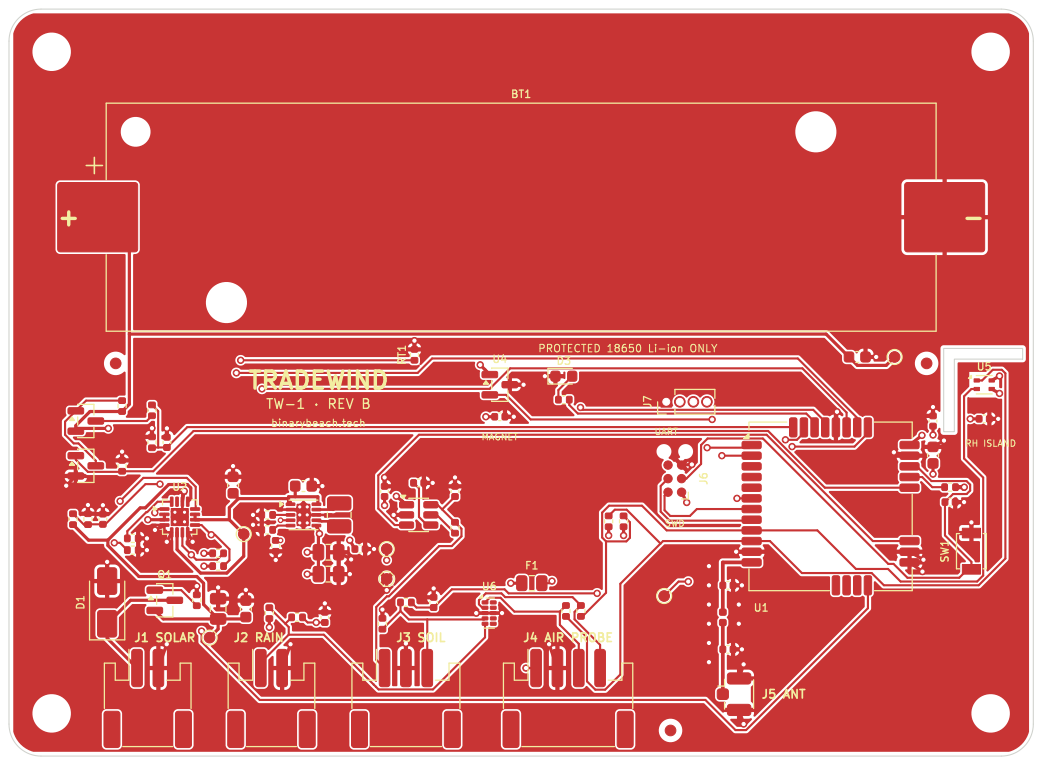
[picture p124: page 1]

J2 RAIN TRADEWIND
J5 ANT TW-1 þÿ·REV B
