binaryBeachLLC/tradewind/hardware/tradewind/tradewind.kicad_pcb

## KiCad design hardware/tradewind/tradewind.kicad_pcb (2026-10-12)

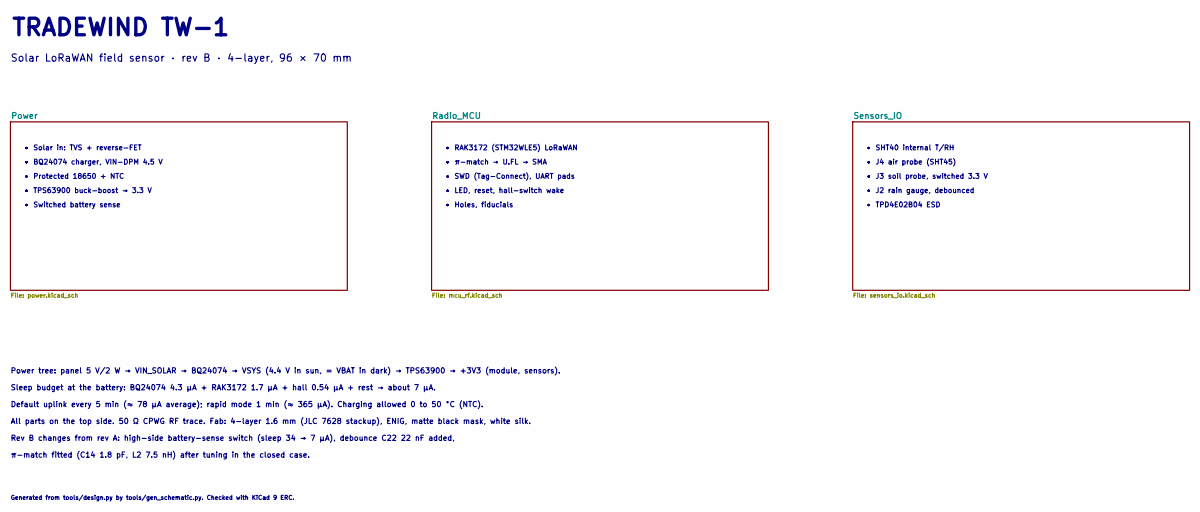
[picture p125: schematic tradewind.kicad_sch, Tradewind TW-1 · Solar LoRaWAN field sensor]

Notes on the sheet:
TRADEWIND TW-1
Solar LoRaWAN field sensor · rev B · 4-layer, 96 × 70 mm
• Solar in: TVS + reverse-FET
• BQ24074 charger, VIN-DPM 4.5 V
• Protected 18650 + NTC
• TPS63900 buck-boost → 3.3 V
• Switched battery sense
• RAK3172 (STM32WLE5) LoRaWAN
• π-match → U.FL → SMA
• SWD (Tag-Connect), UART pads
• LED, reset, hall-switch wake
• Holes, fiducials
• SHT40 internal T/RH
• J4 air probe (SHT45)
• J3 soil probe, switched 3.3 V
• J2 rain gauge, debounced
• TPD4E02B04 ESD
Power tree: panel 5 V/2 W → VIN_SOLAR → BQ24074 → VSYS (4.4 V in sun, = VBAT in dark) → TPS63900 → +3V3 (module, sensors).
Sleep budget at the battery: BQ24074 4.3 µA + RAK3172 1.7 µA + hall 0.54 µA + rest → about 7 µA.
Default uplink every 5 min (≈ 78 µA average); rapid mode 1 min (≈ 365 µA). Charging allowed 0 to 50 °C (NTC).
All parts on the top side. 50 Ω CPWG RF trace. Fab: 4-layer 1.6 mm (JLC 7628 stackup), ENIG, matte black mask, white silk.
Rev B changes from rev A: high-side battery-sense switch (sleep 34 → 7 µA), debounce C22 22 nF added,
π-match fitted (C14 1.8 pF, L2 7.5 nH) after tuning in the closed case.
Generated from tools/design.py by tools/gen_schematic.py. Checked with KiCad 9 ERC.

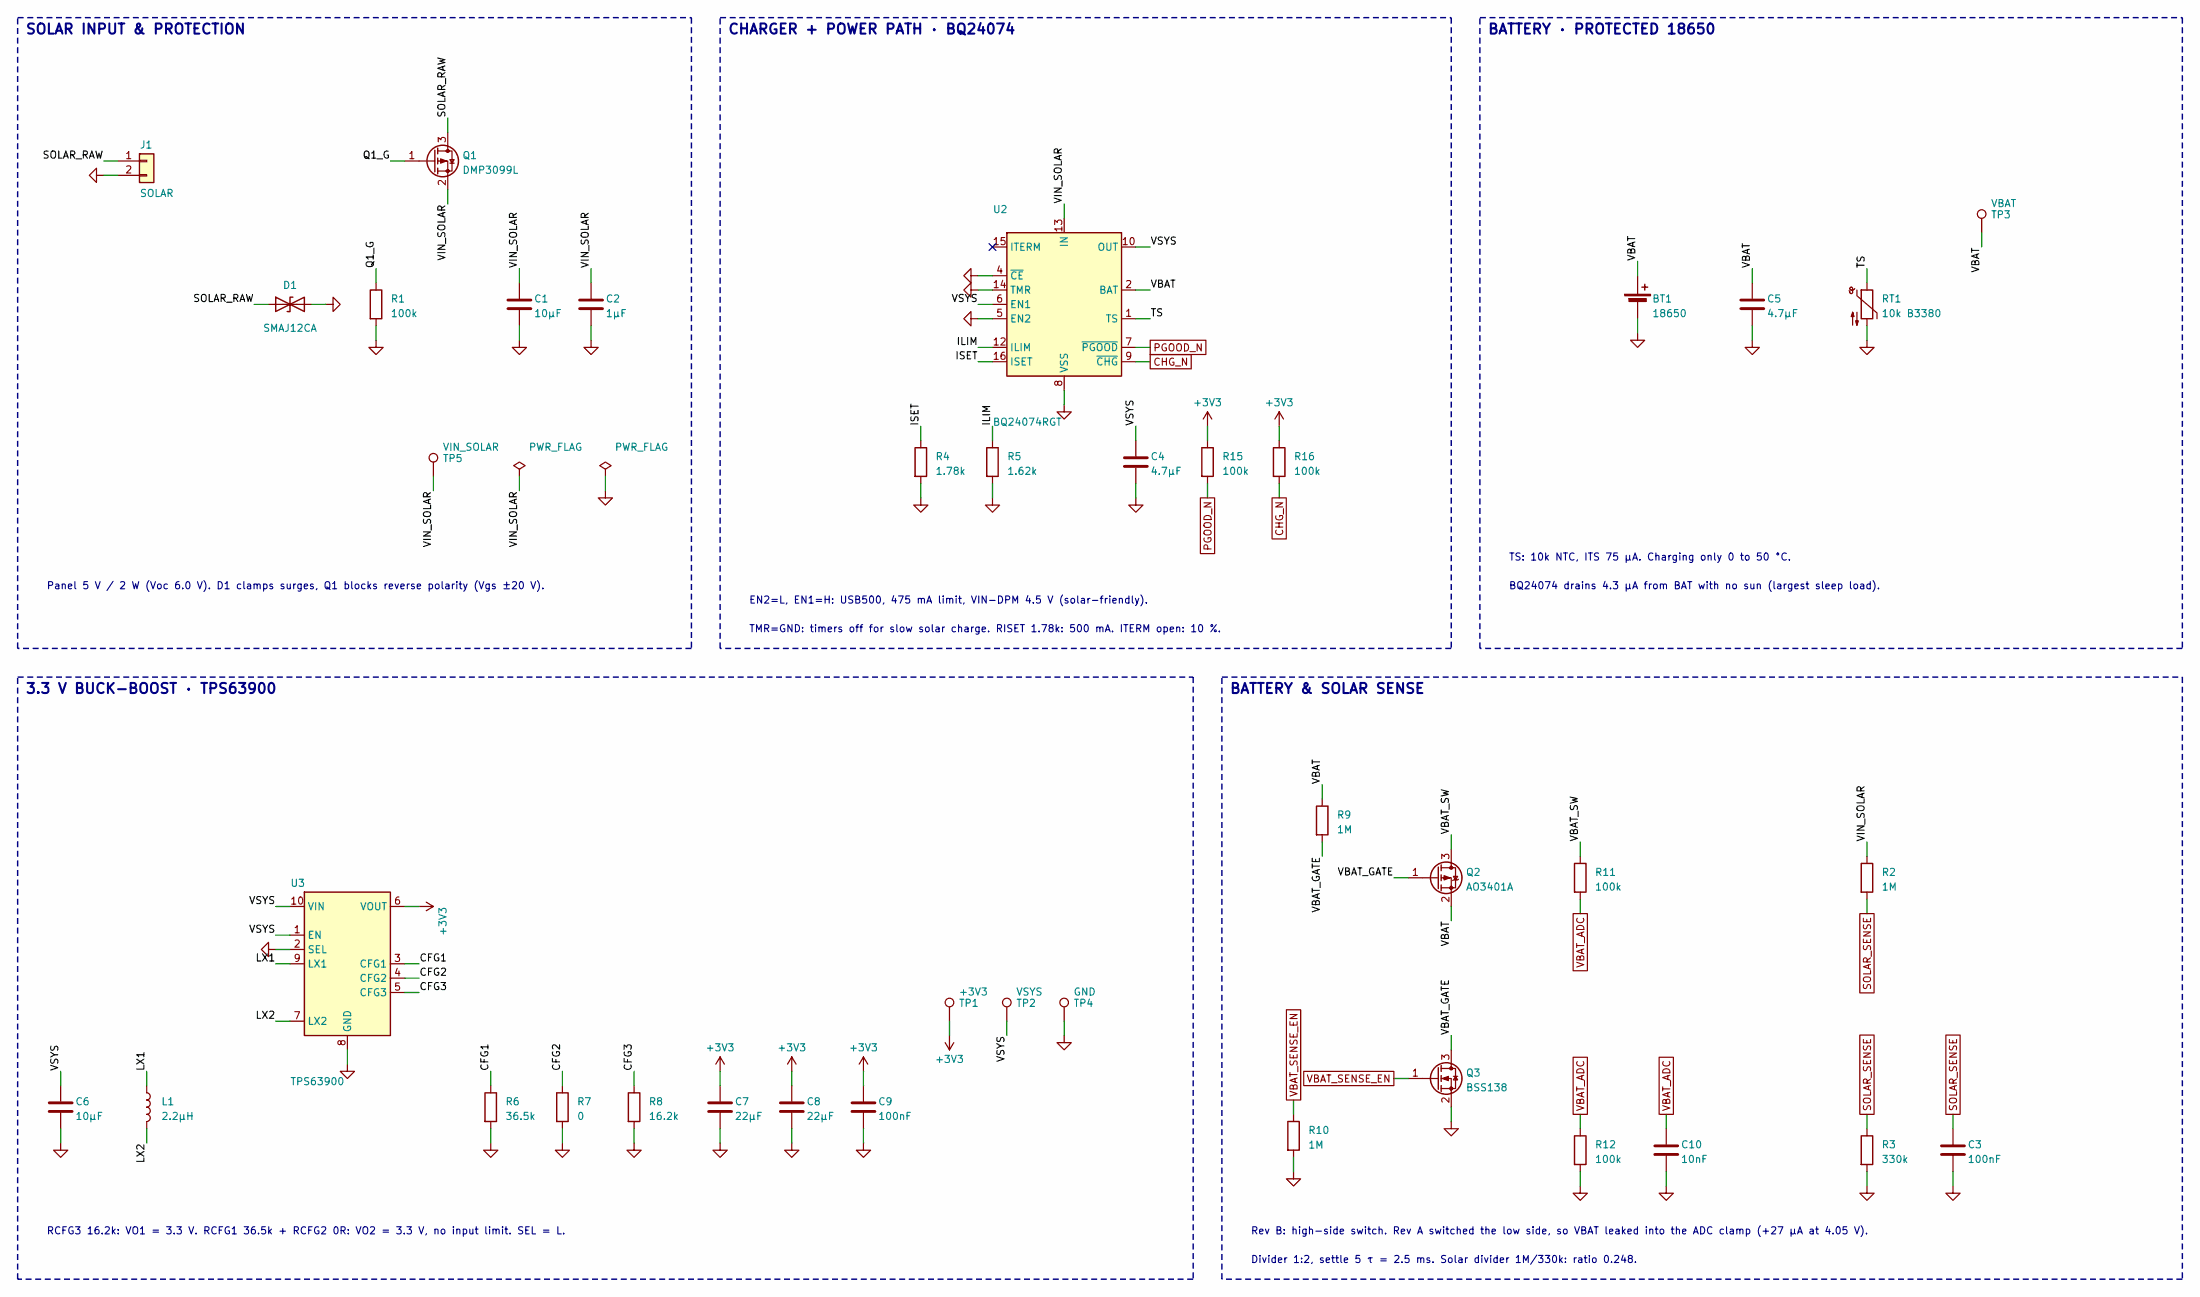
[picture p126: schematic power.kicad_sch, Tradewind TW-1 · Power: solar, charger, battery, 3.3 V]

Parts:
BT1: 18650; BatteryHolder_Keystone_1042_1x18650; MPN 1042
C1: 10µF; C_0805_2012Metric; MPN GRM21BR61E106KA73L
C2: 1µF; C_0603_1608Metric; MPN GRM188R61E105KA12D
C3, C9: 100nF; C_0402_1005Metric; MPN GRM155R71C104KA88D
C4, C5: 4.7µF; C_0603_1608Metric; MPN GRM188R61A475KE15D
C6: 10µF; C_0603_1608Metric; MPN GRM188R61A106KE69D
C7, C8: 22µF; C_0805_2012Metric; MPN GRM21BR61A226ME51L
C10: 10nF; C_0402_1005Metric; MPN GRM155R71C103KA01D
D1: SMAJ12CA; D_SMA; MPN SMAJ12CA
J1: SOLAR; JST_PH_S2B-PH-SM4-TB_1x02-1MP_P2.00mm_Horizontal; MPN S2B-PH-SM4-TB(LF)(SN)
L1: 2.2µH; L_1008_2520Metric; MPN DFE252012F-2R2M=P2
Q1: DMP3099L; SOT-23; MPN DMP3099L-7
Q2: AO3401A; SOT-23; MPN AO3401A
Q3: BSS138; SOT-23; MPN BSS138LT1G
R1, R11, R12, R15, R16: 100k; R_0402_1005Metric; MPN RC0402FR-07100KL
R2, R9, R10: 1M; R_0402_1005Metric; MPN RC0402FR-071ML
R3: 330k; R_0402_1005Metric; MPN RC0402FR-07330KL
R4: 1.78k; R_0402_1005Metric; MPN RC0402FR-071K78L
R5: 1.62k; R_0402_1005Metric; MPN RC0402FR-071K62L
R6: 36.5k; R_0402_1005Metric; MPN RC0402FR-0736K5L
R7: 0; R_0402_1005Metric; MPN RC0402JR-070RL
R8: 16.2k; R_0402_1005Metric; MPN RC0402FR-0716K2L
RT1: 10k B3380; R_0402_1005Metric; MPN NCP15XH103F03RC
TP1: +3V3; TestPoint_Pad_D1.0mm
TP2: VSYS; TestPoint_Pad_D1.0mm
TP3: VBAT; TestPoint_Pad_D1.0mm
TP4: GND; TestPoint_Pad_D1.0mm
TP5: VIN_SOLAR; TestPoint_Pad_D1.0mm
U2: BQ24074RGT; VQFN-16-1EP_3x3mm_P0.5mm_EP1.6x1.6mm; MPN BQ24074RGTR
U3: TPS63900; WSON-10-1EP_2.5x2.5mm_P0.5mm_EP1.2x2mm_ThermalVias; MPN TPS63900DSKR

Connections:
+3V3: C7.1, C8.1, C9.1, R15.1, R16.1, TP1.1, U3.6 (VOUT); also elsewhere on the board
/Power/CFG1: R6.1, U3.3 (CFG1)
/Power/CFG2: R7.1, U3.4 (CFG2)
/Power/CFG3: R8.1, U3.5 (CFG3)
/Power/ILIM: R5.1, U2.12 (ILIM)
/Power/ISET: R4.1, U2.16 (ISET)
/Power/LX1: L1.1, U3.9 (LX1)
/Power/LX2: L1.2, U3.7 (LX2)
/Power/Q1_G: Q1.1 (G), R1.1
/Power/SOLAR_RAW: D1.1 (A1), J1.1, Q1.3 (D)
/Power/TS: RT1.1, U2.1 (TS)
/Power/VBAT: BT1.1 (+), C5.1, Q2.2 (S), R9.1, TP3.1, U2.2 (BAT), U2.3 (BAT)
/Power/VBAT_GATE: Q2.1 (G), Q3.3 (D), R9.2
/Power/VBAT_SW: Q2.3 (D), R11.1
/Power/VIN_SOLAR: C1.1, C2.1, Q1.2 (S), R2.1, TP5.1, U2.13 (IN)
/Power/VSYS: C4.1, C6.1, TP2.1, U2.6 (EN1), U2.10 (OUT), U2.11 (OUT), U3.1 (EN), U3.10 (VIN)
CHG_N: R16.2, U2.9 (~CHG); also elsewhere on the board
GND: BT1.2 (-), C1.2, C2.2, C3.2, C4.2, C5.2, C6.2, C7.2, C8.2, C9.2, C10.2, D1.2 (A2), J1.2, Q3.2 (S), R1.2, R3.2, R4.2, R5.2, R6.2, R7.2, R8.2, R10.2, R12.2, RT1.2, TP4.1, U2.4 (~CE), U2.5 (EN2), U2.8 (VSS), U2.14 (TMR), U2.17 (VSS), U3.2 (SEL), U3.8 (GND), U3.11 (GND); also elsewhere on the board
PGOOD_N: R15.2, U2.7 (~PGOOD); also elsewhere on the board
SOLAR_SENSE: C3.1, R2.2, R3.1; also elsewhere on the board
VBAT_ADC: C10.1, R11.2, R12.1; also elsewhere on the board
VBAT_SENSE_EN: Q3.1 (G), R10.1; also elsewhere on the board

Notes on the sheet:
SOLAR INPUT & PROTECTION
CHARGER + POWER PATH · BQ24074
BATTERY · PROTECTED 18650
3.3 V BUCK-BOOST · TPS63900
BATTERY & SOLAR SENSE
Panel 5 V / 2 W (Voc 6.0 V). D1 clamps surges, Q1 blocks reverse polarity (Vgs ±20 V).
EN2=L, EN1=H: USB500, 475 mA limit, VIN-DPM 4.5 V (solar-friendly).
TMR=GND: timers off for slow solar charge. RISET 1.78k: 500 mA. ITERM open: 10 %.
TS: 10k NTC, ITS 75 µA. Charging only 0 to 50 °C.
BQ24074 drains 4.3 µA from BAT with no sun (largest sleep load).
RCFG3 16.2k: VO1 = 3.3 V. RCFG1 36.5k + RCFG2 0R: VO2 = 3.3 V, no input limit. SEL = L.
Rev B: high-side switch. Rev A switched the low side, so VBAT leaked into the ADC clamp (+27 µA at 4.05 V).
Divider 1:2, settle 5 τ = 2.5 ms. Solar divider 1M/330k: ratio 0.248.

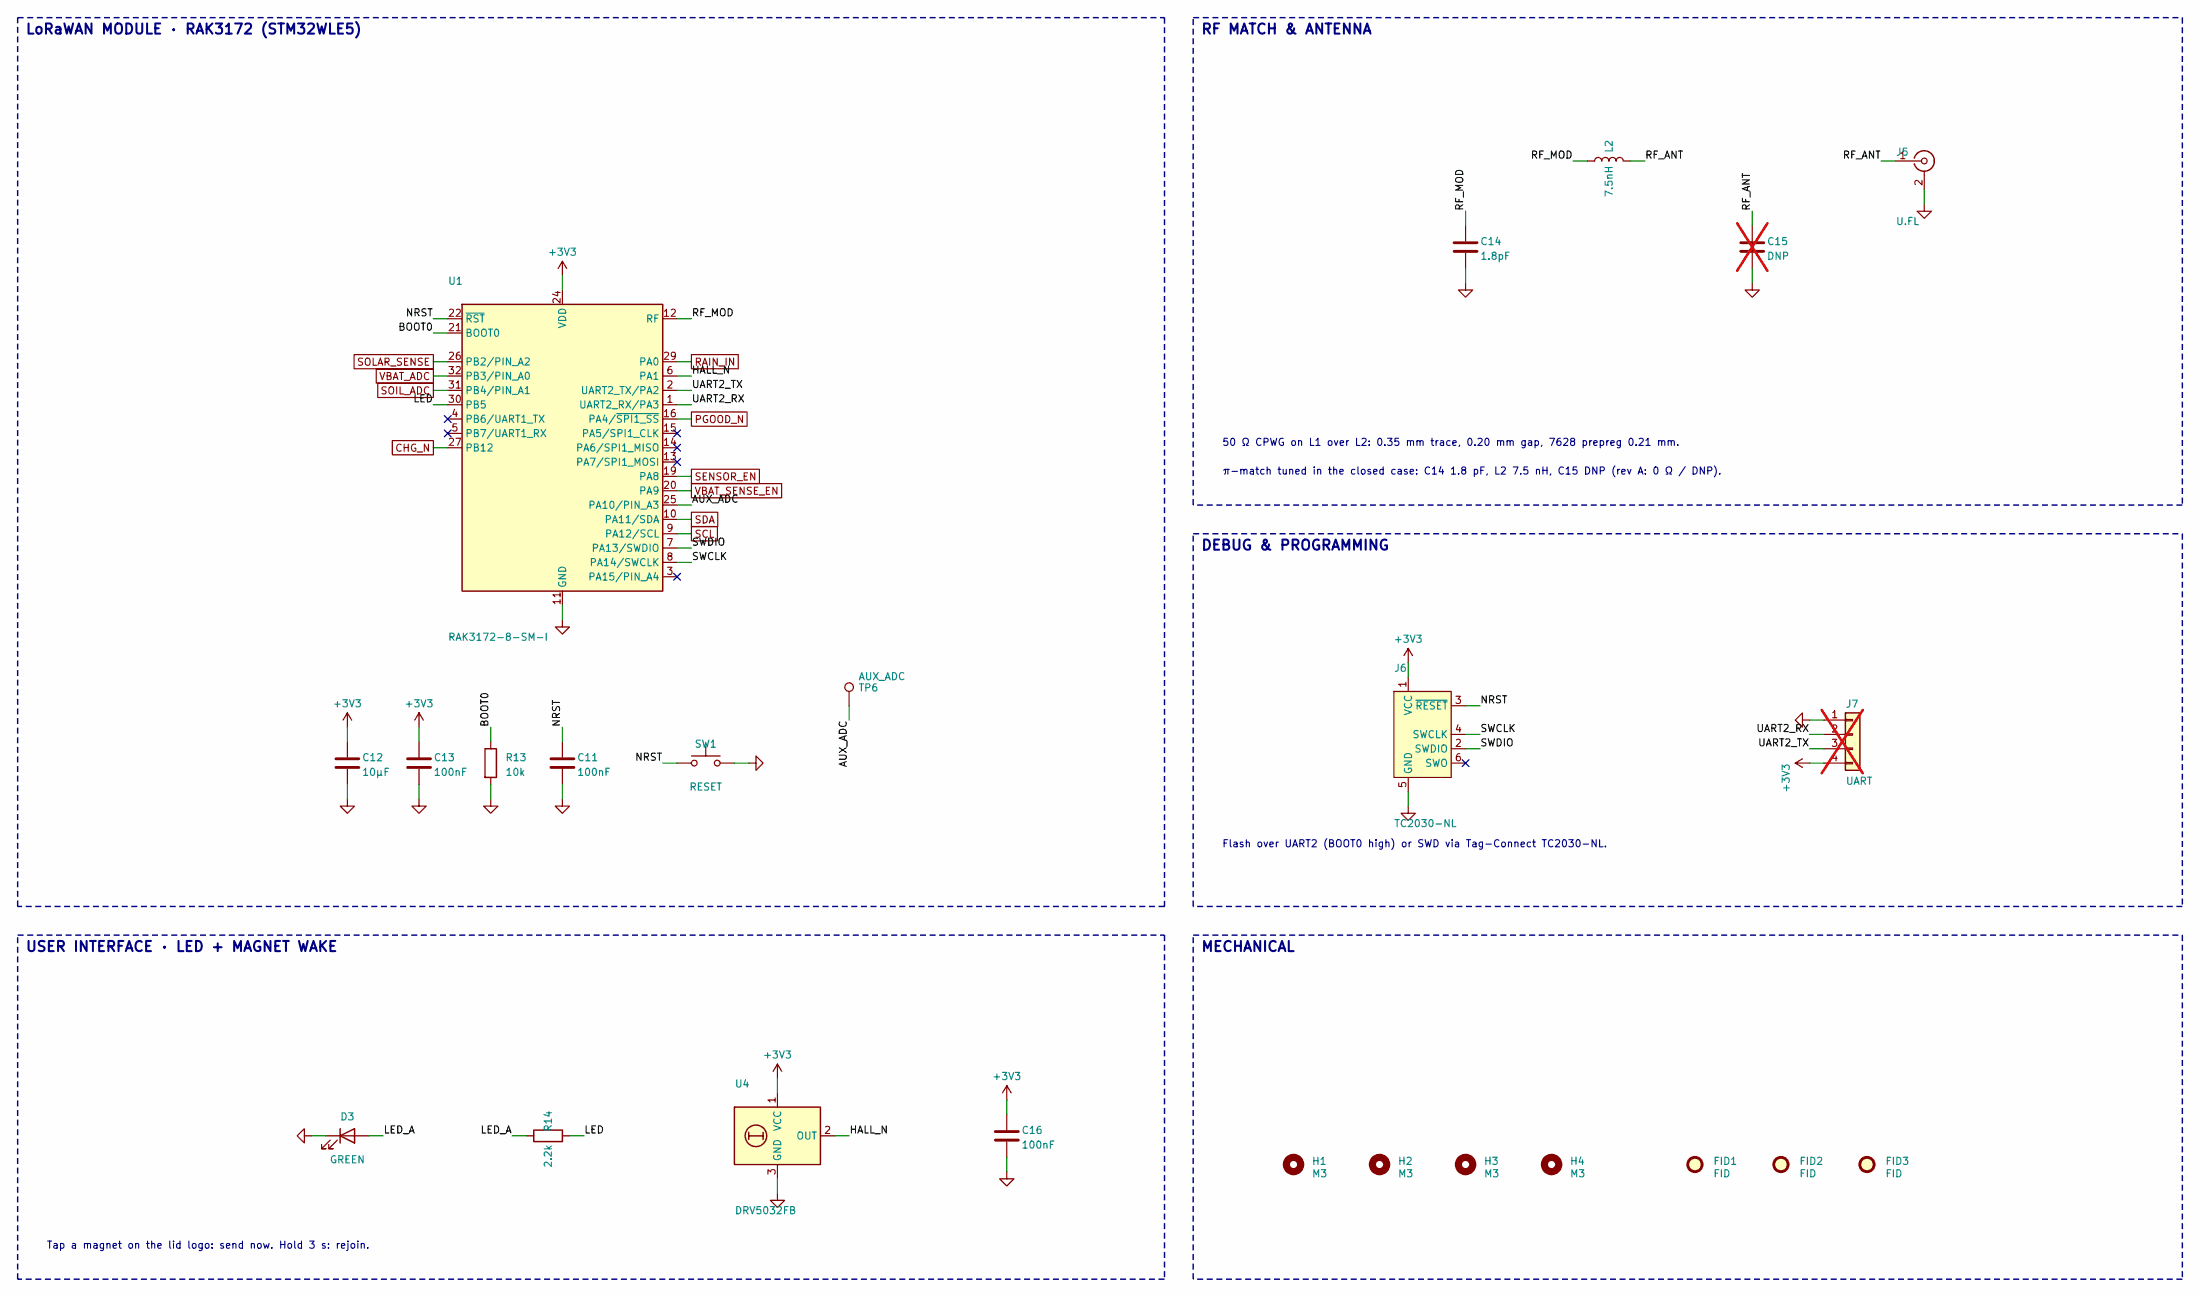
[picture p127: schematic mcu_rf.kicad_sch, Tradewind TW-1 · LoRaWAN module, RF, debug, UI]

Parts:
C11, C13, C16: 100nF; C_0402_1005Metric; MPN GRM155R71C104KA88D
C12: 10µF; C_0603_1608Metric; MPN GRM188R61A106KE69D
C14: 1.8pF; C_0402_1005Metric; MPN GJM1555C1H1R8BB01D
C15: DNP; C_0402_1005Metric; not fitted
D3: GREEN; LED_0603_1608Metric; MPN LTST-C191KGKT
FID1, FID2, FID3: FID; Fiducial_1mm_Mask2mm
H1, H2, H3, H4: M3; MountingHole_3.2mm_M3
J5: U.FL; U.FL_Hirose_U.FL-R-SMT-1_Vertical; MPN U.FL-R-SMT-1(10)
J6: TC2030-NL; Tag-Connect_TC2030-IDC-NL_2x03_P1.27mm_Vertical
J7: UART; PinHeader_1x04_P1.27mm_Vertical; not fitted
L2: 7.5nH; L_0402_1005Metric; MPN LQG15HS7N5J02D
R13: 10k; R_0402_1005Metric; MPN RC0402FR-0710KL
R14: 2.2k; R_0402_1005Metric; MPN RC0402FR-072K2L
SW1: RESET; SW_SPST_B3U-1000P; MPN B3U-1000P
TP6: AUX_ADC; TestPoint_Pad_D1.0mm
U1: RAK3172-8-SM-I; RAK3172; MPN RAK3172-8-SM-I
U4: DRV5032FB; SOT-23; MPN DRV5032FBDBZR

Connections:
+3V3: C12.1, C13.1, C16.1, J6.1 (VCC), J7.4, U1.24 (VDD), U4.1 (VCC); also elsewhere on the board
/Radio_MCU/AUX_ADC: TP6.1, U1.25 (PA10/PIN_A3)
/Radio_MCU/BOOT0: R13.1, U1.21 (BOOT0)
/Radio_MCU/HALL_N: U1.6 (PA1), U4.2 (OUT)
/Radio_MCU/LED: R14.2, U1.30 (PB5)
/Radio_MCU/LED_A: D3.2 (A), R14.1
/Radio_MCU/NRST: C11.1, J6.3 (~RESET), SW1.1, U1.22 (~RST)
/Radio_MCU/RF_ANT: C15.1, J5.1 (In), L2.2
/Radio_MCU/RF_MOD: C14.1, L2.1, U1.12 (RF)
/Radio_MCU/SWCLK: J6.4 (SWCLK), U1.8 (PA14/SWCLK)
/Radio_MCU/SWDIO: J6.2 (SWDIO), U1.7 (PA13/SWDIO)
/Radio_MCU/UART2_RX: J7.2, U1.1 (UART2_RX/PA3)
/Radio_MCU/UART2_TX: J7.3, U1.2 (UART2_TX/PA2)
CHG_N: U1.27 (PB12); also elsewhere on the board
GND: C11.2, C12.2, C13.2, C14.2, C15.2, C16.2, D3.1 (K), J5.2 (Ext), J6.5 (GND), J7.1, R13.2, SW1.2, U1.11 (GND), U1.17 (GND), U1.18 (GND), U1.23 (GND), U1.28 (GND), U4.3 (GND); also elsewhere on the board
PGOOD_N: U1.16 (PA4/~SPI1_SS); also elsewhere on the board
RAIN_IN: U1.29 (PA0); also elsewhere on the board
SCL: U1.9 (PA12/SCL); also elsewhere on the board
SDA: U1.10 (PA11/SDA); also elsewhere on the board
SENSOR_EN: U1.19 (PA8); also elsewhere on the board
SOIL_ADC: U1.31 (PB4/PIN_A1); also elsewhere on the board
SOLAR_SENSE: U1.26 (PB2/PIN_A2); also elsewhere on the board
VBAT_ADC: U1.32 (PB3/PIN_A0); also elsewhere on the board
VBAT_SENSE_EN: U1.20 (PA9); also elsewhere on the board

Notes on the sheet:
LoRaWAN MODULE · RAK3172 (STM32WLE5)
RF MATCH & ANTENNA
DEBUG & PROGRAMMING
USER INTERFACE · LED + MAGNET WAKE
MECHANICAL
50 Ω CPWG on L1 over L2: 0.35 mm trace, 0.20 mm gap, 7628 prepreg 0.21 mm.
π-match tuned in the closed case: C14 1.8 pF, L2 7.5 nH, C15 DNP (rev A: 0 Ω / DNP).
Flash over UART2 (BOOT0 high) or SWD via Tag-Connect TC2030-NL.
Tap a magnet on the lid logo: send now. Hold 3 s: rejoin.

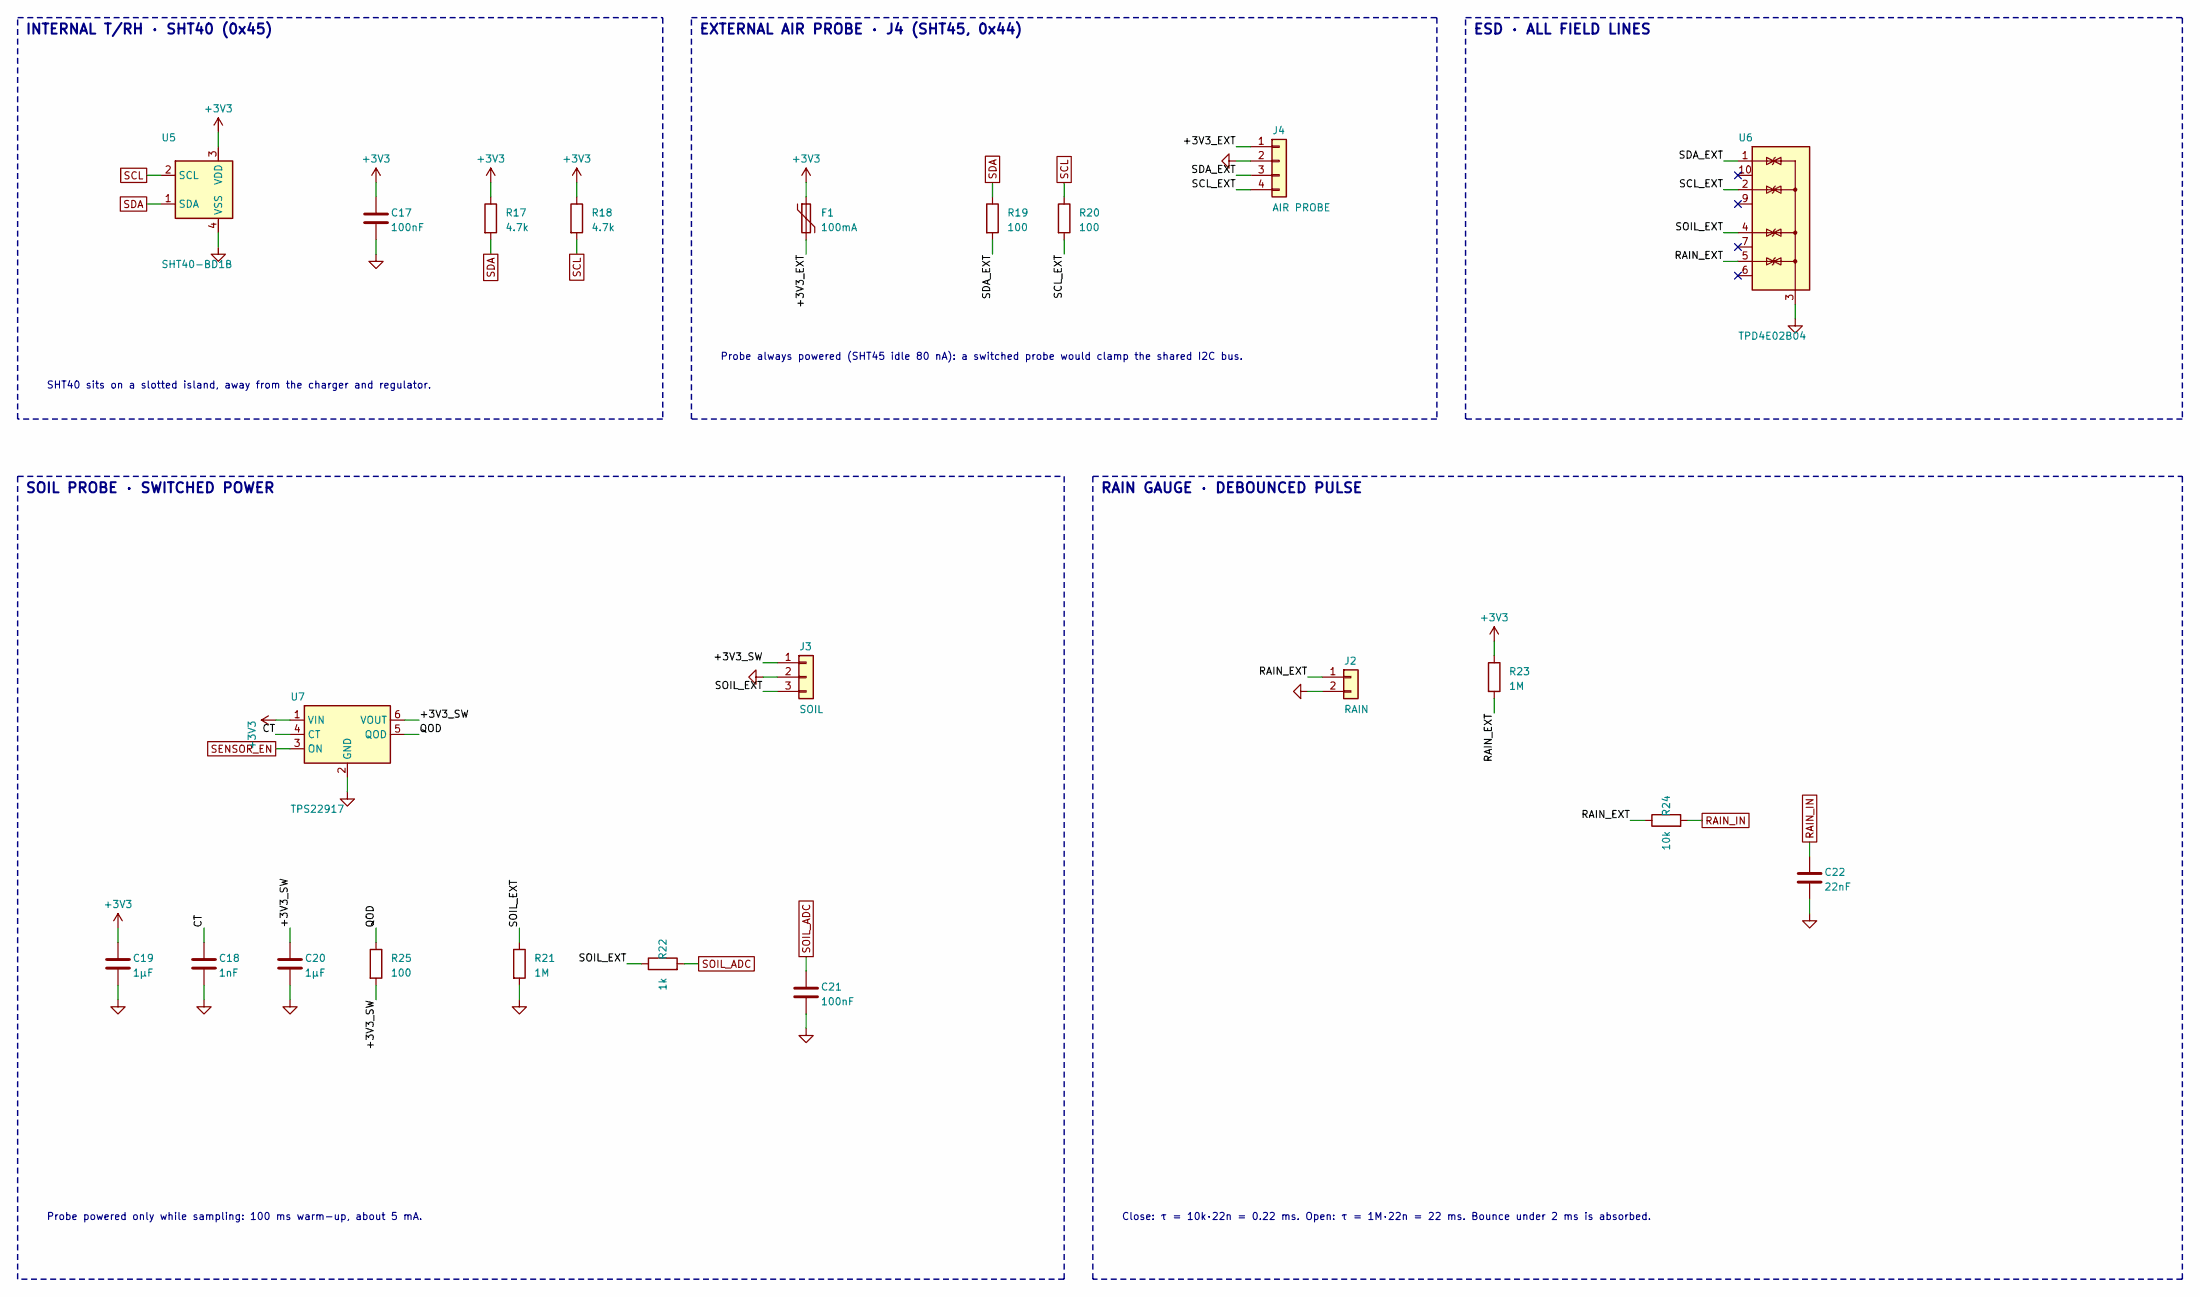
[picture p128: schematic sensors_io.kicad_sch, Tradewind TW-1 · Sensors and field I/O]

Parts:
C17, C21: 100nF; C_0402_1005Metric; MPN GRM155R71C104KA88D
C18: 1nF; C_0402_1005Metric; MPN GRM155R71H102KA01D
C19, C20: 1µF; C_0402_1005Metric; MPN GRM155R61A105KE15D
C22: 22nF; C_0402_1005Metric; MPN GRM155R71C223KA01D
F1: 100mA; Fuse_0805_2012Metric; MPN MF-PSMF010X-2
J2: RAIN; JST_PH_S2B-PH-SM4-TB_1x02-1MP_P2.00mm_Horizontal; MPN S2B-PH-SM4-TB(LF)(SN)
J3: SOIL; JST_PH_S3B-PH-SM4-TB_1x03-1MP_P2.00mm_Horizontal; MPN S3B-PH-SM4-TB(LF)(SN)
J4: AIR PROBE; JST_PH_S4B-PH-SM4-TB_1x04-1MP_P2.00mm_Horizontal; MPN S4B-PH-SM4-TB(LF)(SN)
R17, R18: 4.7k; R_0402_1005Metric; MPN RC0402FR-074K7L
R19, R20, R25: 100; R_0402_1005Metric; MPN RC0402FR-07100RL
R21, R23: 1M; R_0402_1005Metric; MPN RC0402FR-071ML
R22: 1k; R_0402_1005Metric; MPN RC0402FR-071KL
R24: 10k; R_0402_1005Metric; MPN RC0402FR-0710KL
U5: SHT40-BD1B; Sensirion_DFN-4_1.5x1.5mm_P0.8mm_SHT4x_NoCentralPad; MPN SHT40-BD1B-R2
U6: TPD4E02B04; USON-10_2.5x1.0mm_P0.5mm; MPN TPD4E02B04DQAR
U7: TPS22917; SOT-23-6; MPN TPS22917DBVR

Connections:
+3V3: C17.1, C19.1, F1.1, R17.1, R18.1, R23.1, U5.3 (VDD), U7.1 (VIN); also elsewhere on the board
/Sensors_IO/+3V3_EXT: F1.2, J4.1
/Sensors_IO/+3V3_SW: C20.1, J3.1, R25.2, U7.6 (VOUT)
/Sensors_IO/CT: C18.1, U7.4 (CT)
/Sensors_IO/QOD: R25.1, U7.5 (QOD)
/Sensors_IO/RAIN_EXT: J2.1, R23.2, R24.1, U6.5 (IO4)
/Sensors_IO/SCL_EXT: J4.4, R20.2, U6.2 (IO2)
/Sensors_IO/SDA_EXT: J4.3, R19.2, U6.1 (IO1)
/Sensors_IO/SOIL_EXT: J3.3, R21.1, R22.1, U6.4 (IO3)
GND: C17.2, C18.2, C19.2, C20.2, C21.2, C22.2, J2.2, J3.2, J4.2, R21.2, U5.4 (VSS), U6.3 (G), U6.8 (G), U7.2 (GND); also elsewhere on the board
RAIN_IN: C22.1, R24.2; also elsewhere on the board
SCL: R18.2, R20.1, U5.2 (SCL); also elsewhere on the board
SDA: R17.2, R19.1, U5.1 (SDA); also elsewhere on the board
SENSOR_EN: U7.3 (ON); also elsewhere on the board
SOIL_ADC: C21.1, R22.2; also elsewhere on the board

Notes on the sheet:
INTERNAL T/RH · SHT40 (0x45)
EXTERNAL AIR PROBE · J4 (SHT45, 0x44)
ESD · ALL FIELD LINES
SOIL PROBE · SWITCHED POWER
RAIN GAUGE · DEBOUNCED PULSE
Probe always powered (SHT45 idle 80 nA): a switched probe would clamp the shared I2C bus.
SHT40 sits on a slotted island, away from the charger and regulator.
Probe powered only while sampling: 100 ms warm-up, about 5 mA.
Close: τ = 10k·22n = 0.22 ms. Open: τ = 1M·22n = 22 ms. Bounce under 2 ms is absorbed.

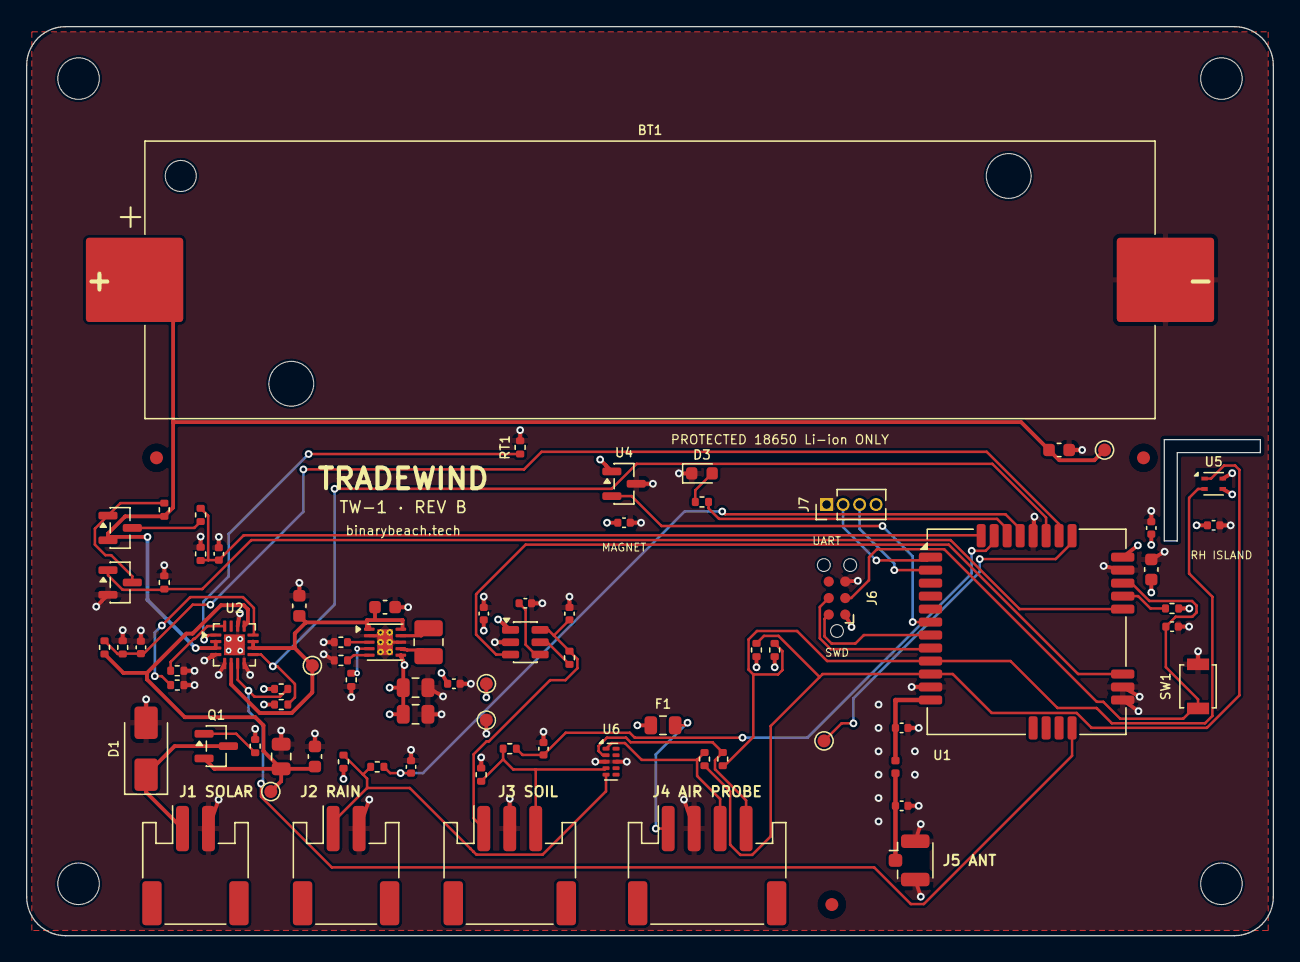
[picture p129: board tradewind.kicad_pcb from above]

Board: 4 copper layers, 96.0 x 70.0 mm, 85 parts (0 on the bottom side), 47 nets.
