binaryBeachLLC/tradewind/(commit log)

2026-10-12 Tradewind TW-1 rev B: solar LoRaWAN field sensor, concept to field pilot
    Design-as-code KiCad 9 project (schematic + routed 4-layer board, ERC/DRC clean),
    fab package (Gerbers, drill, costed BOM, CPL, STEP/GLB), CadQuery enclosure system,
    RUI3 firmware with payload codec and decoder tests, nine ngspice/Python simulations,
    characterization and field-pilot analysis, Blender renders, engineering report and
    product datasheet (HTML + PDF).
    [BOM_JLCPCB.csv, BOM_mechanical.csv, BOM_tradewind_revB.csv, Cell_18650_protected.step, JST_PH_S2B-PH-SM4-TB.step, JST_PH_S3B-PH-SM4-TB.step, JST_PH_S4B-PH-SM4-TB.step, RAK3172.step]
2026-10-12 Report: per-board electrical, layout and EMI/EMC package (35 pages)
    Section 4 is now the full package for the main board: schematic notes per
    block, electrical considerations (high-current paths, fast/HF and sensitive
    nets, I2C over the probe cable, ADC settling), BOM considerations and
    derating, PCB layout (stackup, zoning, power and RF close-ups, review
    findings) and EMI/EMC/ESD with pre-compliance results. Section 5 covers the
    bought sub-assemblies.
    - tools/layout_audit.py measures the routed board (copper paths, hot loops,
    switch node, RF line and via fence); tools/layout_figs.py draws from it
    - sim/board_si.py: DC drop, I2C rise time, harmonic attenuation of the
    match, ADC settling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
    [emi_radiated_prescan.csv, emi_radiated_qp.csv, rx_desense.csv, tx_harmonics_conducted.csv]
2026-10-12 Report readability: larger text, full-width charts, pad-accurate layout labels
    Body 11 pt, tables and captions 9.5 pt, 8.5 pt floor in every chart. New tools/paginate.py flows
    chapters in Chrome and prints charts full width instead of in half columns. Layout figures outline
    each part from its pads and place numbered markers on computed features. Report is 46 pages.
