binaryBeachLLC/tradewind/(notices)

Notices in the files:
hardware/tradewind/tradewind.kicad_pcb:
Binary Beach LLC · Honolulu, Hawaiʻi · CERN-OHL-P-2.0
